jbussmann/glaL2-Leiterplatte/Spezifikation_Bussmann.pptx

## Spezifikation eigene Leiterplatte

Blockschaltbild

- B

Power

Stromversorgung
DC/DC Converter
In: 5-24V
Out: 3.3V, max. 3A

3-Phasen Brücke
verwendbar als:
- H-Brücke
- Push-Pull
- Open-Drain

Core

Analog

8x Single-Ended ADC
mit SGA x1 x10 x50 und
Sp.-Teiler x1/30 x1/3

2x Potentiometer

Digital/Interface

Embedded ST-LINK/V2-1

MicroSD Slot

8x RGB-LEDs via
latched Shift-Registers

QVGA LCD (320x240)
mit resistive Touch

SWD-Interface

Microcontroller
STMicroelectronics
ARM Cortex M4 + FPU
STM32F411VC
3x I2C/USART, 5x SPI
11x Timer, 12bit ADC

2 Achsen Joystick

5-Weg Taster

USB mit Serial + DFU

Rotary Encoder, gerastert

SPI, I2C, USART

## Spezifikation eigene Leiterplatte

Kostenrelevante Bauteile:
- ohne 0805/0603
- R E24, C E12
