jbussmann/glaL2-Leiterplatte/Datasheets_Comp/Thumbstick_Ada_P2765.jpg

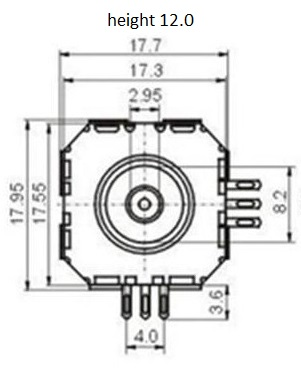
Datasheets_Comp/Thumbstick_Ada_P2765.jpg
