jbussmann/glaL2-Leiterplatte/Datasheets_MCU/Pinout.png

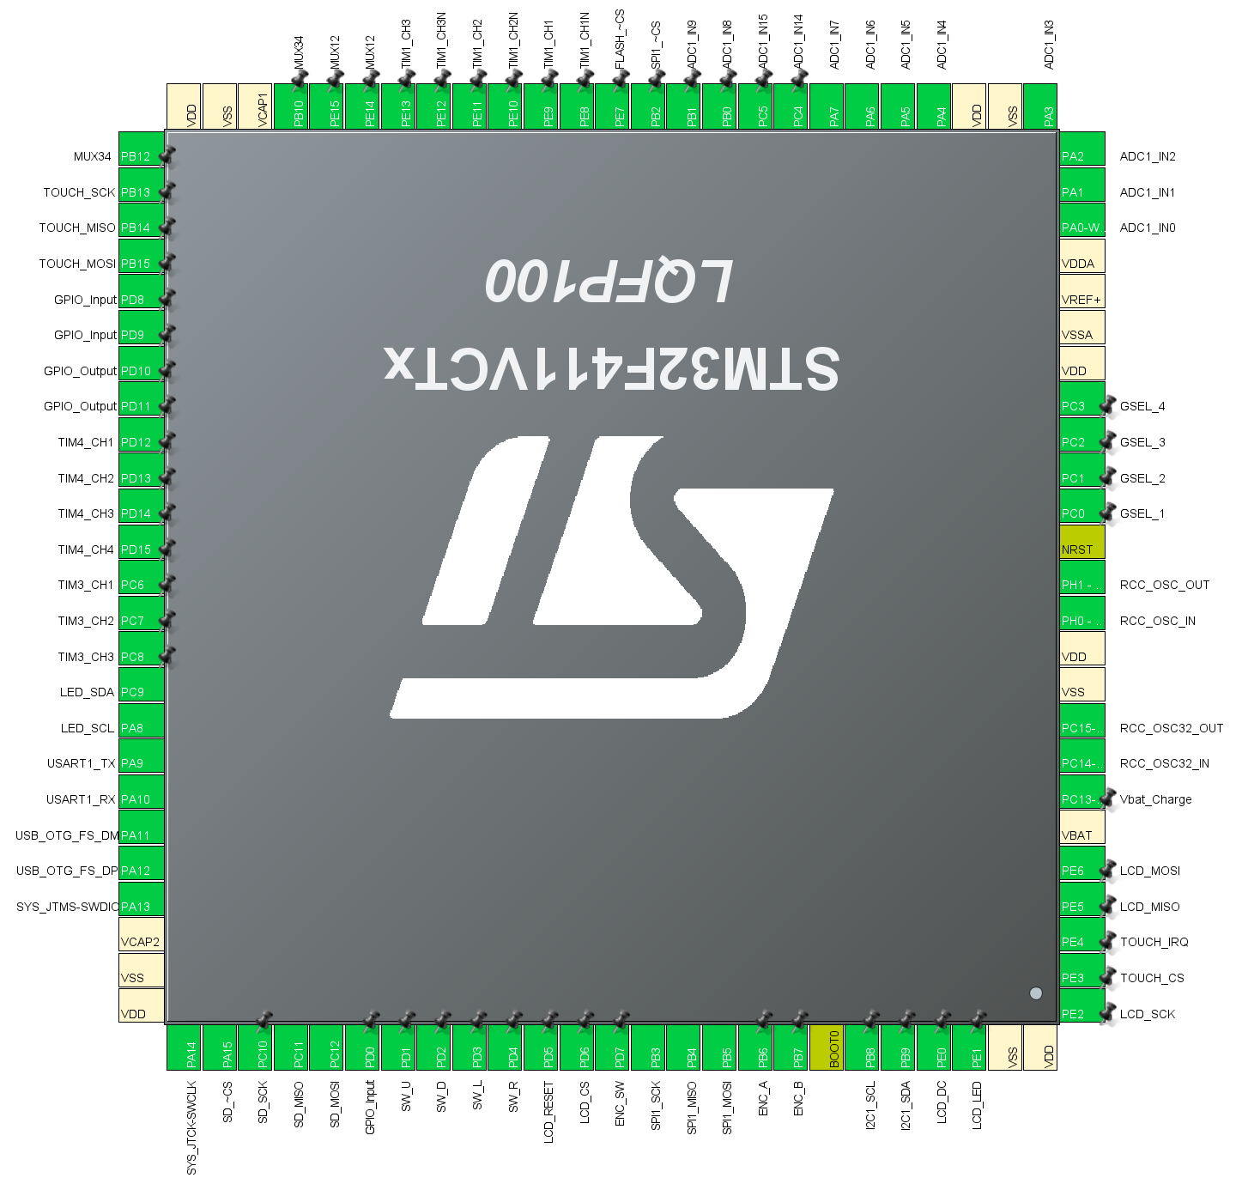
Datasheets_MCU/Pinout.png
