jbussmann/glaL2-Leiterplatte/Bauteilliste_Bussmann.xlsx

Qty | VALUE | MF | DESCRIPTION | Dist. | Order Nr. | Price | Total
 | Power
1 | AP63300WU-7 | Diodes inc | Schaltspannungsregler DCDC Conv HV Buck TSOT26 T&R 3K | Mouser | 621-AP63300WU-7 | 0.95
1 | ASPI-0630LR-5R6M-T15 | ABRACON | Festinduktivitäten FIXED IND 5.6UH 6A 35.5 MOHM SMD | Mouser | 810-VLS6045EX-4R7M | 0.79 | 0.79
1 | MIC5504-3.3YM5-TR | Micrel | LDO Spannungs-Regulator Single 300mA LDO | Mouser | 998-MIC5504-3.3YM5TR | 0.13 | 0.13
2 | MCP1804T-3302I/OT | Microchip | LDO Spannungs-Regulator 150mA LDO Vin 28V Vout =3.3V | Mouser | 579-MCP1804T-3302IOT | 0.66 | 1.32
4 | PMEG3020EGWX | Nexperia | Schottky Dioden & Gleichrichter SCHOTTKY DIODE | Mouser | 841-PMEG3020EGWX | 0.32 | 1.28
2 | 20020327-C021B01LF | Amphenol | Feste Anschlussblöcke 2P 3.50MM | Mouser | 649-220327-C021B01LF | 0.59
2 | 20020327-C051B01LF | Amphenol | Feste Anschlussblöcke 5P 3.50MM | Mouser | 649-220327-C051B01LF | 0.84 | 1.68
2 | 860010675018 | Wurth | Aluminium-Elektrolyt-Kondensatoren - Radial bedrahtet WCAP-ATG8 220uF 50V 20% Radial | Mouser | 710-860010675018 | 0.41 | 0.82
1 | GRM21BR61E226ME44K | Murata | MLCC - SMD/SMT 22UF 25V 20% 0805 | Mouser | 81-GRM21BR61E226ME4K | 0.44
3 | GRT21BR60J476ME13L | Murata | MLCC - SMD/SMT X5R 6.3Vdc 47uF VDC&Temp Derate Rcmd | Mouser | 81-GRT21BR60J476ME3L | 0.47
4 | 74279220601 | Wurth | Ferritperlen WE-MPSB 0805 100MHz 600Ohm 2100mA AECQ2 | Mouser | 710-74279220601 | 0.31
3 | STD64N4F6AG | STM | MOSFET LGS LV MOSFET | Mouser | 511-STD64N4F6AG | 0.62 | 1.86
3 | STD36P4LLF6 | STM | MOSFET LGS LV MOSFET | Mouser | 511-STD36P4LLF6 | 0.98 | 2.94
 | Core
1 | STM32F411VCT6 | STM | ARM Mikrocontroller - MCU 16/32-BITS MICROS | Mouser | 511-STM32F411VCT6 | 5.67
1 | STM32F103CBT6 | STM | ARM Mikrocontroller - MCU 32BIT Cortex M3 128K MED Performance LN | Mouser | 511-STM32F103CBT6 | 5.21
2 | ECS-80-8-30Q-VS-TR | ECS | Quarze 8MHz 8pF AEC ESR 100 -40C +125C | Mouser | 520-80-8-30Q-VST | 0.68 | 1.36
1 | CM8V-T1A-32.768kHz-4pF-20PPM-TA-QC T3 | Micro Crystal | Quarze 32.768 kHz 4.0 pF +/-20 PPM -40/+85C | Mouser | 428-202684-MC03 | 0.81 | 0.81
2 | USB3075-30-A | GCT | USB-Stecker Micro B Skt, Bottom-SMT, R/A, 30u No Peg, W/shell stake, T&R | Mouser | 640-USB3075-30-A | 0.63 | 1.26
4 | KMR421GULCLFS | C&K | Sensorschalter Tact | Mouser | 611-KMR421GULCLFS | 0.38 | 1.52
1 | BC847C | Nexperia | Bipolartransistoren - BJT NPN GP 100MA 45V | Mouser | 771-BC847C-T/R | 0.12
 | Analog
1 | MCP1501T-30E/CHY | Microchip | Spannungsreferenzen Precision Buffered Voltage Reference | Mouser | 579-MCP1501T-30E/CHY | 0.75 | 0.75
2 | RK10J11E0034 | Alps Alpine | Potentiometer Single Unit 10mm,1B insertion (2mm) | Mouser | 688-RK10J11E0034 | 1.43 | 2.86
1 | SKRHABE010 | Alps Alpine | Multi-direktionale Schalter 4-directn cntr push W/boss 200K Cycles | Mouser | 688-SKRHAB | 2.46 | 2.46
1 | 2765 | Adafruit | Adafruit Zubehör Mini 2-Axis Analog Thumbstick | Mouser | 485-2765 | 2.29 | 2.29
1 | PEC11S-929K-S0015 | Bourns | Encoder 9.5 MM SHAFT W/SWITCH 2 DET | Mouser | 652-PEC11S929K-S0015 | 2.1 | 2.1
4 | MCP6G02-E/MS | Microchip | Sonderverstärker Single Selectable Gain Amplifiers | Mouser | 579-MCP6G02-E/MS | 0.6 | 2.4
 | Digital/Interface
8 | CLV1L-FKB-CJ1N1E1BB7B3B3 | Cree | Standard-LEDs - SMD RGB SMD | Mouser | 941-CLV1LFKBCJ1N1E1B | 0.34 | 2.72
5 | 150060VS55040 | Wurth | Standard-LEDs - SMD WL-SMCD SMD MonoChip 0603 BrtGrn 575nm | Mouser | 710-150060VS55040 | 0.17
4 | 150060SS55040 | Wurth | Standard-LEDs - SMD WL-SMCD SMD MonoChip 0603 Super Red 645nm | Mouser | 710-150060SS55040 | 0.17
2 | LP5012PWR | TI | 12-channel I2C constant-current RGB LED driver 24 | Mouser | 595-LP5012PWR | 1.19 | 2.38
1 | BZT52C11TQ-7-F | Diodes inc | Zener-Dioden Zener Diode SOD523 | Mouser | 621-BZT52C11TQ-7-F | 0.26 | 0.26
3 | SMH-104-02-T-S | Samtec | Sockel & Kabelgehäuse .100 Horizontal Surface Mount 4-Pin | Mouser | 200-SMH10402TS | 0.9 | 2.7
3 | SMH-106-02-T-S | Samtec | Sockel & Kabelgehäuse .100 Horizontal Surface Mount 6-Pin | Mouser | 200-SMH10602TS | 0.97 | 2.91
1 | MEM2061-01-188-00-A | GCT | Speicherkartenverbinder Micro SD Push Push, Closed, SMT, 1.88mm profile | Mouser | 640-MEM20610118800A | 1.06
1 | AT25SF641B-SHB-B | Adesto | NOR-Flash 64 Mbit, 3.0V (2.7V to 3.6V), -40C to 85C, SOIC-W 208mil (Tube) | Mouser | 988-AT25SF641B-SHB-B | 0.87 | 0.87
1 |  |  | Display LCD Touch 2.4" QVGA | ebay | 284089088933 | 8
 |  |  |  |  |  | TOTAL | 40.47
