jbussmann/glaL2-Leiterplatte/Vorlage_Bestellliste.xlsx

 | Qty | Reference | VALUE | MF | DESCRIPTION | Dist. | Order Nr. | Price | Total
1 | 1 | D104 | NRVBS3100T3G | On-Semi | Schottky-Gleichrichterdiode, AEC-Q101, 100 V, 3 A, Einfach, SMC, 2 Pin(s), 900 mV | Farnell | 2533243 | 0.46 | 0.46
2 | 2 | D102, D103 | B360A-13-F | Diodes inc | Schottky Dioden & Gleichrichter 60V 3A Schottky Dioden & Gleichrichter 60V 3A | Mouser | 621-B360A-F | 0.14 | 0.28
3 | 2 | RV401, RV402 | RK09K1130AH1 | Alps | RK09K1130AH1 - Drehpotentiometer, 10 kohm, 1 Umdrehung(en), Linear, 50 mW, ± 20%, Baureihe RK09 | Farnell | 1191725 | 0.768 | 1.536
4 | 1 | J102 | TB007-508-02BE | CUI | 2-Pol Anschlussblock schraubbar, 5.08mm | Mouser | 490-TB007-508-02BE | 0.203 | 0.203
5 | 3 | J201, J203, J503 | TB007-508-04BE | CUI | 4-Pol Anschlussblock schraubbar, 5.08mm | Mouser | 490-TB007-508-04BE | 0.405 | 1.215
6 | 1 | J202 | TB007-508-05BE | CUI | 5-Pol Anschlussblock schraubbar, 5.08mm | Mouser | 490-TB007-508-05BE | 0.602 | 0.602
7 | 2 | JP101, JP302 | 77311-118-02LF | FCI | CONN HEADER VERT 2POS 2.54MM | Mouser | 649-77311-118-02LF | 0.123 | 0.246
8 | 1 | J401 | M20-7820446 | Harwin | Sockel & Kabelgehäuse 4 PIN SIL VERTICAL SOCKET TIN | Mouser | 855-M20-7820446 | 0.62 | 0.62
9 | 1 | external | SBC-OLED01 | JOY-IT | DEBO OLED2 0.96 Entwicklerboards - Display, 0,96", OLED-Display, SSD1306 | Reichelt | DEBO OLED2 0.96 | 6.51 | 6.51
10 | 1 | D401 | ASMB-MTB0-0A3A2 | Broadcom | LED, RGB, Rot, Grün, Blau, Oberflächenmontage, 2.4mm, 115 °, Rund, R 20mA, G 20mA, B 20mA | Farnell | ASMB-MTB0-0A3A2 | 0.398 | 0.398
11 | 1 | U101 | TPS54331D | TI | Schaltspannungsregler 3A 28V In Step Down SWIFT DC/DC Cnvrtr | Mouser | 595-TPS54331D | 1.55 | 1.55
12 | 1 | L101 | 7447779006 | Wurth | Festinduktivitäten WE-PD 7345 6.8uH 2.91A .033Ohm | Mouser | 710-7447779006 | 1.91 | 1.91
13 | 1 | U304 | STM32F070RBT6 | STM | ARM Mikrocontroller - MCU Mainstream ARM Cortex-M0 Value line MCU with 128 Kbytes Flash, 48 MHz CPU, USB | Mouser | 511-STM32F070RBT6 | 2.35 | 2.35
14 | 6 | Q201, Q202, Q203, Q204, Q205, Q206 | NVD3055L170T4GVF | On-Semi | MOSFET NFET DPAK 60V 9A 1 70MOHM | Mouser | 863-NVD3055L170T4GVF | 0.413 | 2.478
15 | 3 | F201, F202, F203 | 0ZCH0020FF2E | Bel-Fuse | Rückstellbare Sicherungen - PPTC Fuse 0.2A Haltestrom 0.4A Auslösestrom 30V | Mouser | 530-0ZCH0020FF2E | 0.067 | 0.201
16 | 3 | D203, D204, 402 | BAV99HMFHT116 | ROHM | Dioden (Allzweck, Leistung, Schaltung) 100V Vrm; 500mA Ifm Swtch Diode SOT-23 | Mouser | 755-BAV99HMFHT116 | 0.062 | 0.186
17 | 1 | J101 | 629105150521 | Wurth | USB-Steckverbinder, mit Einraststiften, Micro-USB Typ B | Farnell | 2470822 | 1.58 | 1.58
18 | 6 | SW301, SW401, SW402, SW403, SW404, SW405 | FSM6JH | TE | Sensorschalter SPST OFF-(ON) Round pushbutton | Mouser | 506-FSM6JH | 0.11 | 0.66
19 | 1 | U501 | ADUM1201AR | Analog Devices | Digitale Isolatoren DUAL-CHANNEL DIGITAL ISOLATORS | Mouser | 584-ADUM1201AR | 2.98 | 2.98
20 | 1 | U502 | MAX13487EESA+ | MAXIM | RS-422/RS- 485-Schnittstelle IC Half-Duplex RS-485/RS-422-Compatible Transceiver with AutoDirection Control | Mouser | 700-MAX13487EESA | 2.16 | 2.16
21 | 1 | SW406 | PEC12R-4015F-S00024 | Bourns | PEC12R-4015F-S0024 Inkrementalgeber | Mouser | 652-PEC12R4015FS0024 | 1.07 | 1.07
22 | 1 | D403 | LTP-305G | Liteon | LED 5 x 7 Dot Matrix | Mouser | 859-LTP-305G | 2.2 | 2.2
23 | 1 | Y301 | ABS25-32.768KHZ-6-T | Abracon | Quarze 32.768KHz 6pF 20ppm -40C +85C | Mouser | 815-ABS25-32.768K6-T | 0.466 | 0.466
24 | 1 | Y302 | HC49SDLF-8.00MHz | FOX | Quarze 8MHz 12pF -20C +70C 30ppm | Mouser | 559-FOXSDLF/080-12 | 0.302 | 0.302
25 | 6 | D201, D202, D205, D206, D207, D208 | FM240A | Rectron | 40V 2A SMB Diode | Mouser | 583-FM240A | 0.093 | 0.558
26 | 2 | C102, C208 | ESW227M050AH2AA | Kemet | Aluminium-Elektrolyt-Kondensatoren - Radial bedrahtet 50V 220uF 105C 5k Hour Radial | Mouser | 80-ESW227M050AH2AA | 0.314 | 0.628
27 | 1 | C111 | EEU-FR1A471 | Panasonic | Aluminium-Elektrolyt-Kondensatoren - Radial bedrahtet 10VDC 470uF 20% L/S=3.5mm | Mouser | 667-EEU-FR1A471 | 0.244 | 0.244
28 | 1 | D101 | SMAJ28AQ-13-F | Diodes inc | ESD-Entstörer/TVS-Dioden 400W Transient Voltage Suppressor | Mouser | 621-SMAJ28AQ-13-F | 0.288 | 0.288
29 | 1 | external |  |  | SWD Program Adapter |  |  | 12 | 12
30 | 2 | C106, C107 | ESW226M010AC3AA | Kemet | Aluminium-Elektrolyt-Kondensatoren - Radial bedrahtet 10V 22uF 105C 3k Hour Radial | Mouser | 80-ESW226M010AC3AA | 0.078 | 0.156
31 | 4 | FB101, FB102, FB103, FB301 | 74279220601 | Wurth | Ferritperle, 0805 [Metrisch 2012], 600 ohm, 2.1 A, Baureihe WE-MPSB, 0.08 ohm, ± 25% | Farnell | 2467189 | 0.27 | 1.08
32 | 1 | J301 | M20-7820646 | Harwin | Sockel & Kabelgehäuse 6 PIN SIL VERTICAL SOCKET TIN | Mouser | 855-M20-7820646 | 0.728 | 0.728
33 | 1 | Q401 | BC847C | Nexperia | Bipolartransistoren - BJT NPN GP 100MA 45V | Mouser | 771-BC847C-T/R | 0.1 | 0.1
34 | 1 | U305 | SN65220DBVT | TI | ESD-Entstörer/TVS-Dioden Single USB Port | Mouser | 595-SN65220DBVT | 0.8 | 0.8
35 | 1 | U303 | ULN2003 | TI | Darlington Transistors | Mouser | 595-ULN2003V12DR | 0.473 | 0.473
36 | 2 | U301, U302 | 74HC164 | TI | Counter Shift Register | Mouser | 595-CD74HC164ME4 | 0.637 | 1.274
37 | 1 | LS401 | Speaker | PUI Audio | Lautspecher SMD | Mouser | 665-SMT-0927-S-12-R | 1.61 | 1.61
38 | 1 | J402 | AudioJack3 | CUI Devices | 3.5 Audio Jack | Mouser | 490-SJ1-3533NG | 0.85 | 0.85
 |  |  |  |  |  |  |  | TOTAL | 52.952
