jbussmann/glaL2-Leiterplatte/Vorlage_Schema.pdf

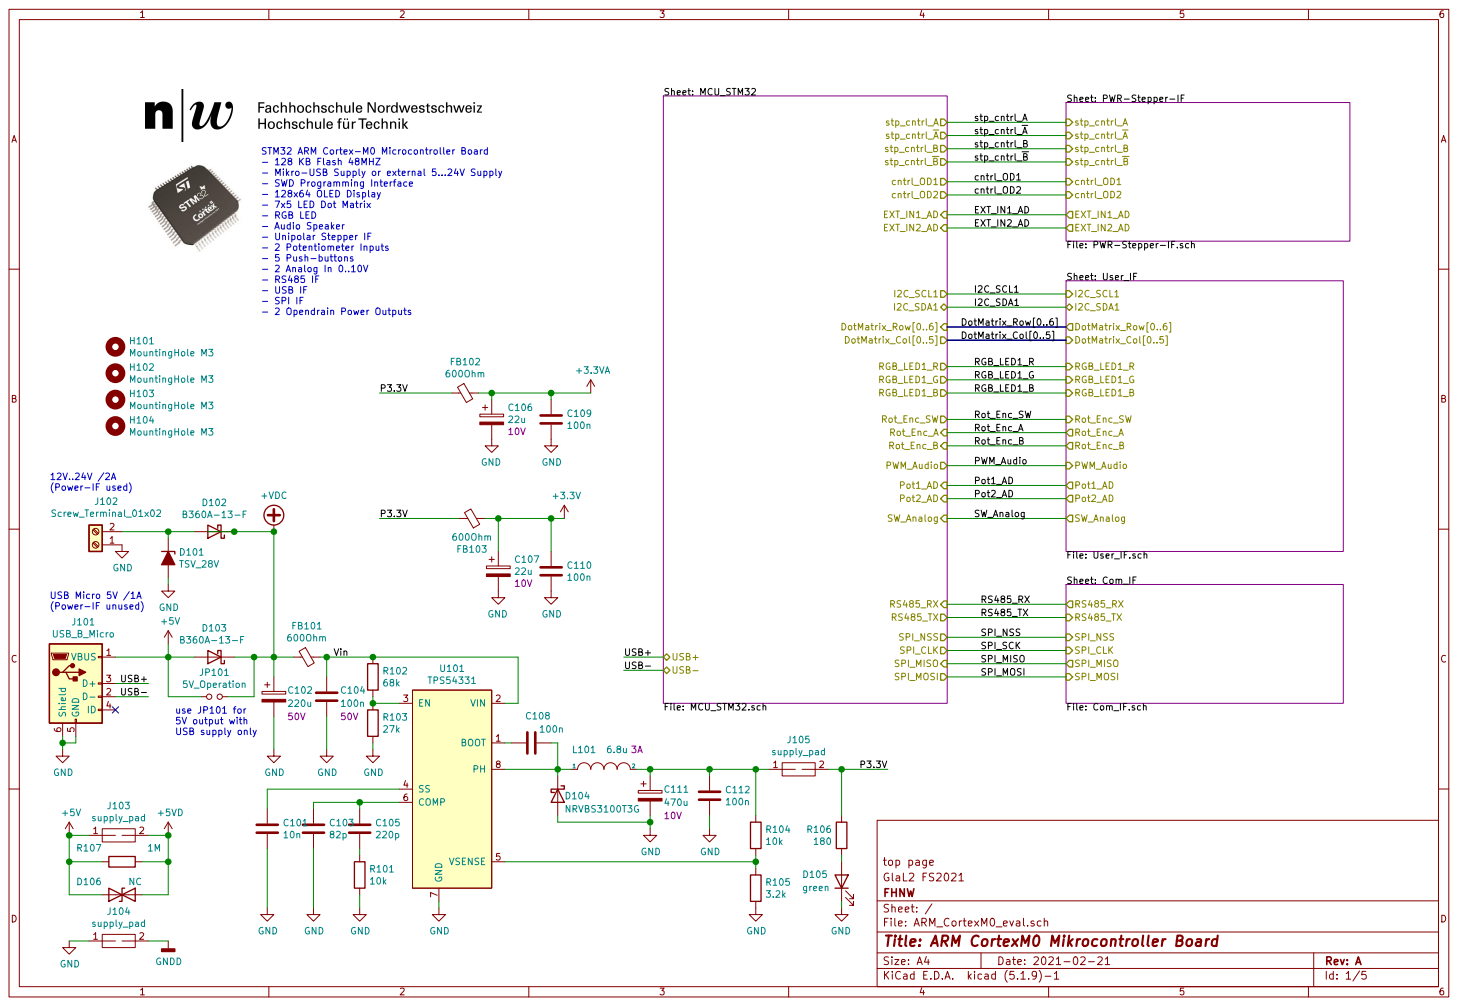
[picture p6: page 1]

STM32 ARM Cortex-M0 Microcontroller Board
- 128 KB Flash 48MHZ - Mikro-USB Supply or external 5...24V Supply

I2C_SCL1 USB- USB+ USB Micro 5V /1A

180 H104 MountingHole M3 H103 MountingHole M3 H102 MountingHole M3 H101 MountingHole M3

GlaL2 FS2021
File: ARM_CortexM0_eval.sch Sheet: / FHNW

Id: 1/5 Title: ARM CortexM0 Mikrocontroller Board

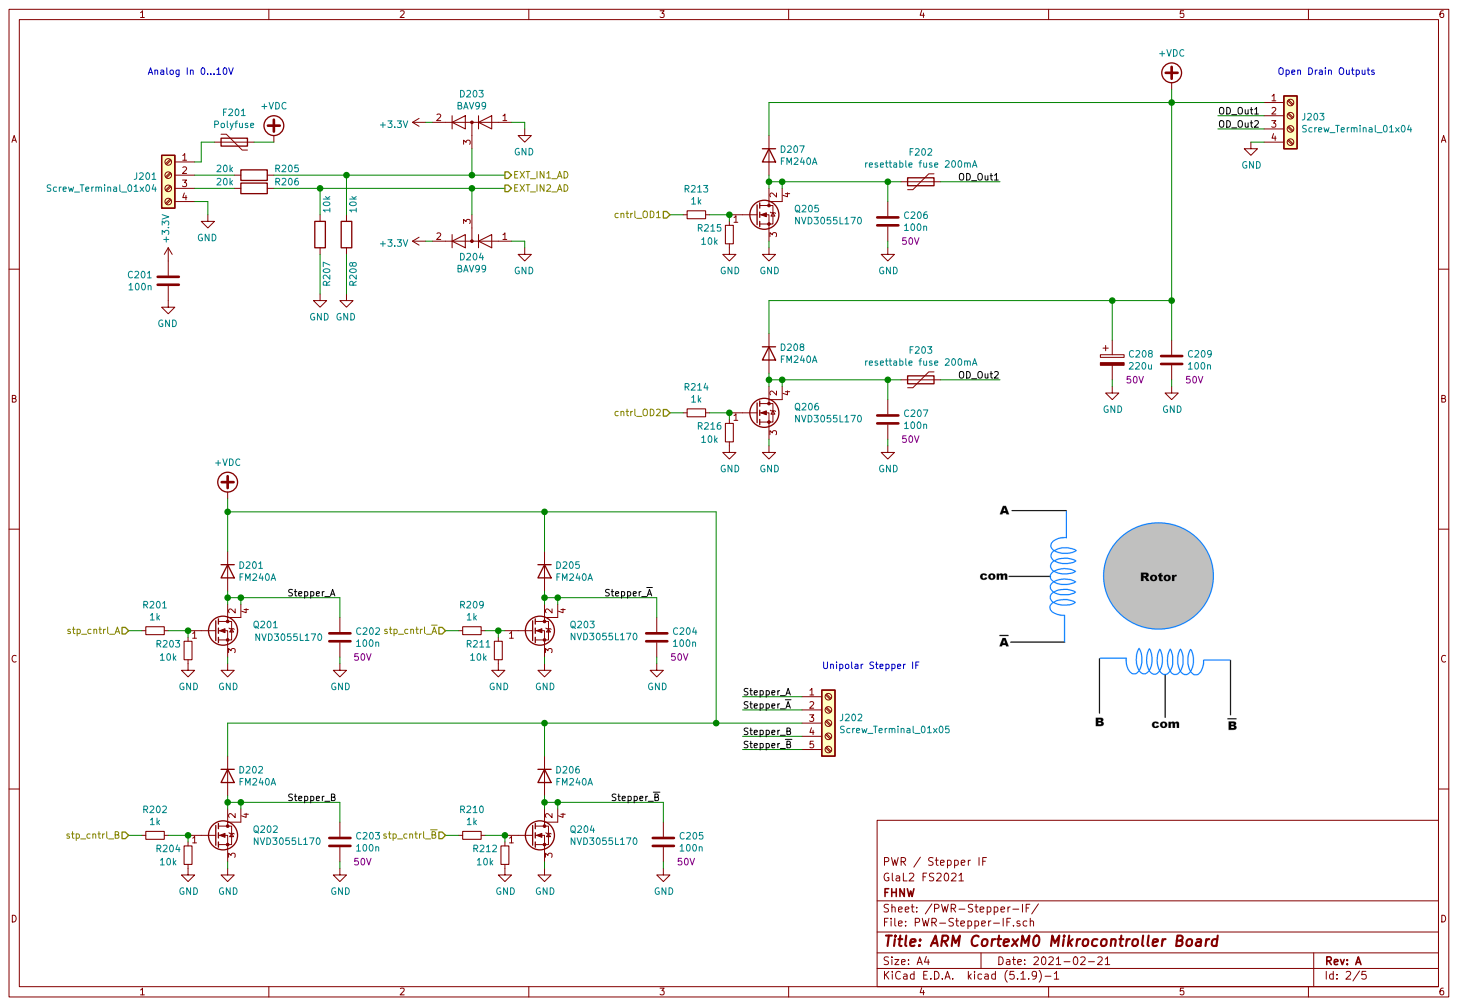
[picture p7: page 2]

Sheet: /PWR-Stepper-IF/ FHNW

File: PWR-Stepper-IF.sch
Id: 2/5 Title: ARM CortexM0 Mikrocontroller Board

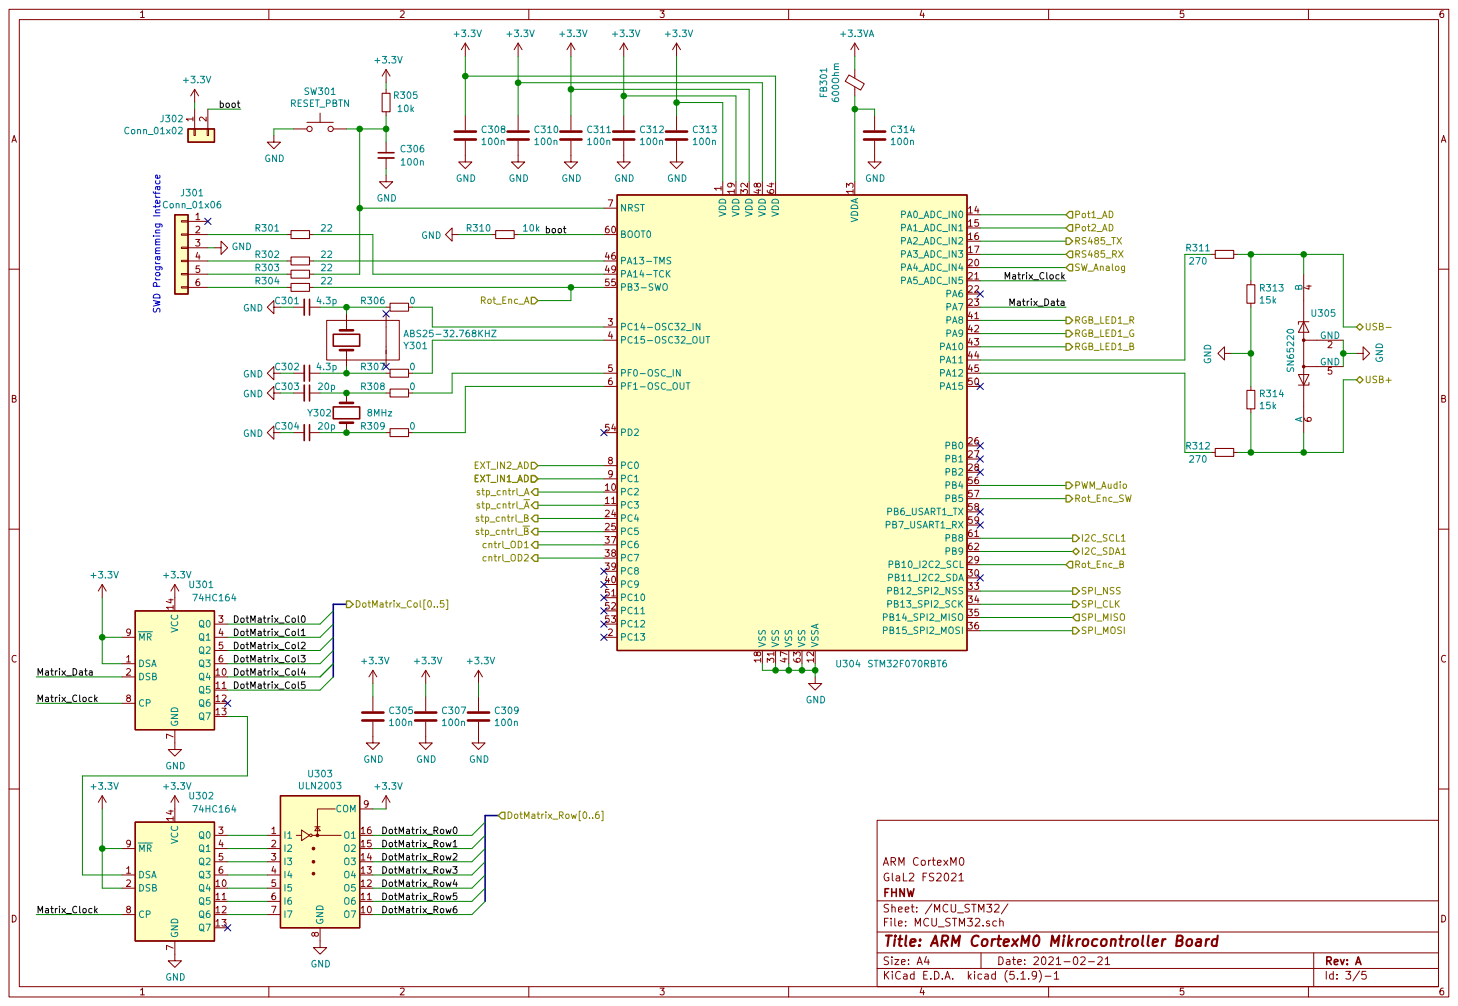
[picture p8: page 3]

1 PC2 10 PC3 11 VSSA 12 VDDA 13 PA0_ADC_IN0 14 PA1_ADC_IN1 15 PA2_ADC_IN2 16 PA3_ADC_IN3 17 VSS 18 VDD 19 PC13 2 PA4_ADC_IN4 20 PA5_ADC_IN5 21 PA6 22 PA7 23 PC4 24 PC5 25 PB0 26 PB1 27 PB2 28 PB10_I2C2_SCL 29 PC14-OSC32_IN 3 PB11_I2C2_SDA 30 VSS 31 VDD 32 PB12_SPI2_NSS 33 PB13_SPI2_SCK 34 PB14_SPI2_MISO 35 PB15_SPI2_MOSI 36 PC6 37 PC7 38 PC8 39 PC15-OSC32_OUT 4 PC9 40 PA8 41 PA9 42 PA10 43 PA11 44 PA12 45 PA13-TMS 46 VSS 47 VDD 48 PA14-TCK 49 PF0-OSC_IN 5 PA15 50 PC10 51 PC11 52 PC12 53 PD2 54 PB3-SWO 55 PB4 56 PB5 57 PB6_USART1_TX 58 PB7_USART1_RX 59 PF1-OSC_OUT 6 BOOT0 60 PB8 61 PB9 62 VSS 63 VDD 64 NRST 7 PC0 8 PC1 9 U304 STM32F070RBT6

File: MCU_STM32.sch
Id: 3/5 Title: ARM CortexM0 Mikrocontroller Board

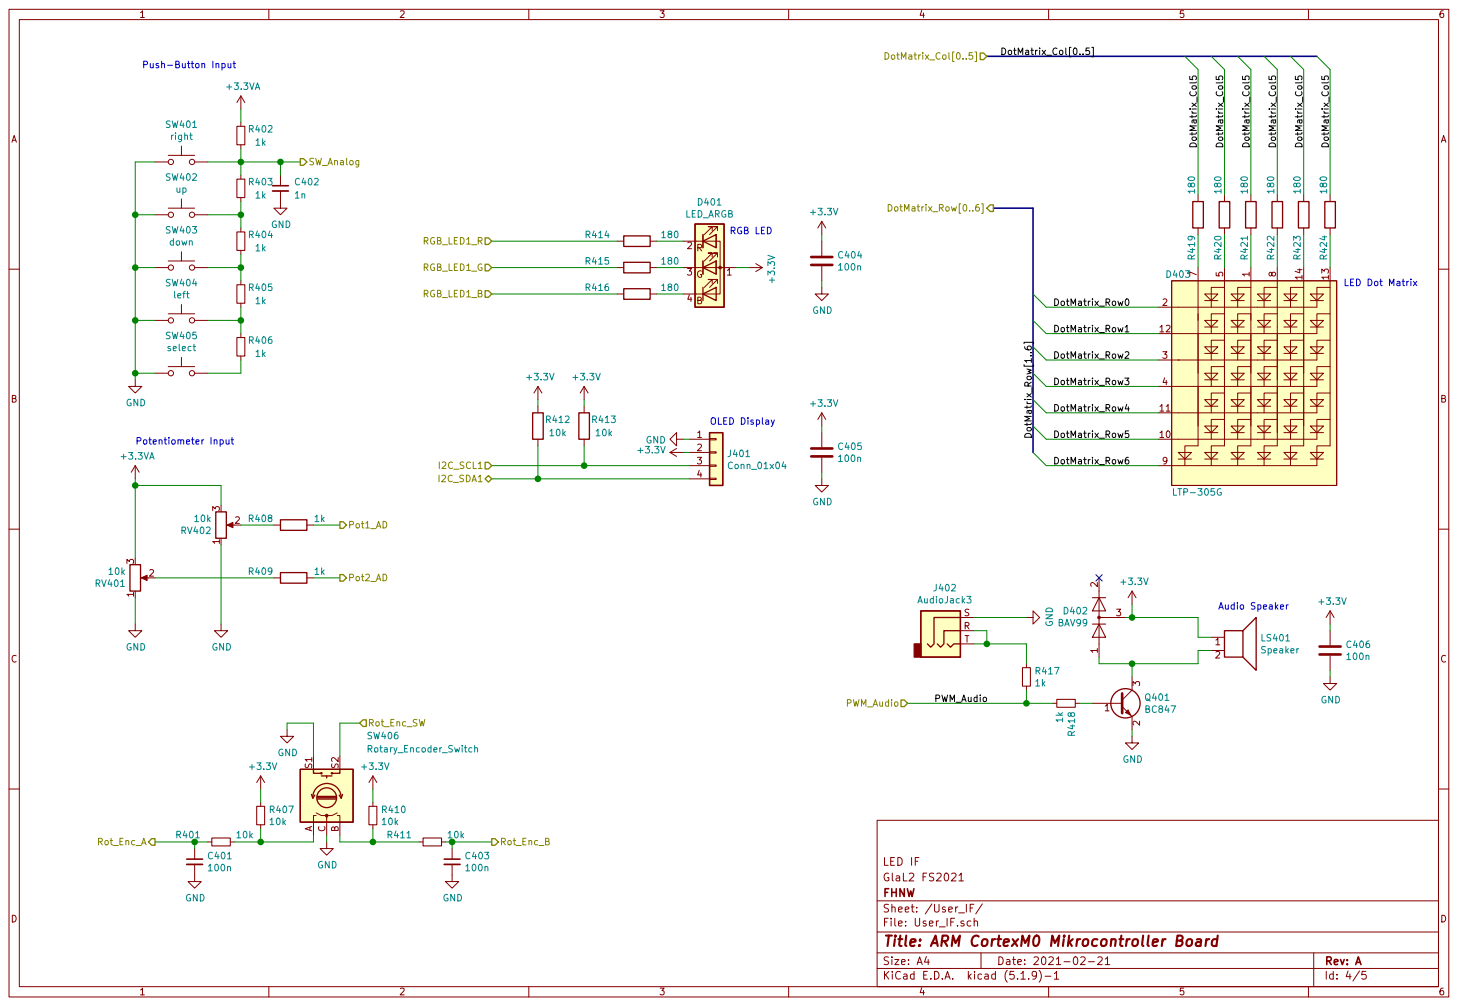
[picture p9: page 4]

File: User_IF.sch
Id: 4/5 Title: ARM CortexM0 Mikrocontroller Board

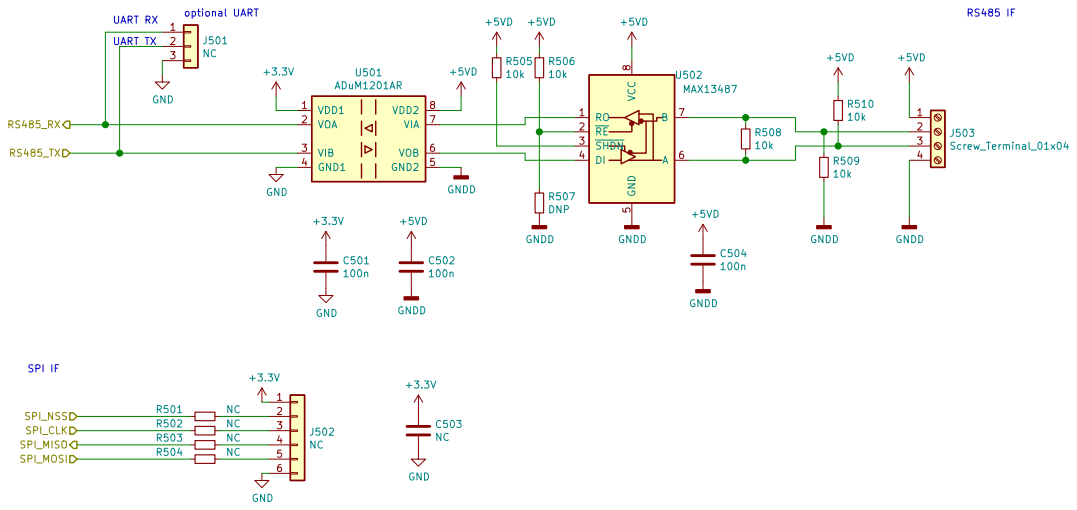
[picture p10: page 5]

optional UART UART RX

File: Com_IF.sch
Id: 5/5 Title: ARM CortexM0 Mikrocontroller Board
