jbussmann/glaL2-Leiterplatte/KiCad/PDF/STM32-Evalboard-B_Fab.pdf

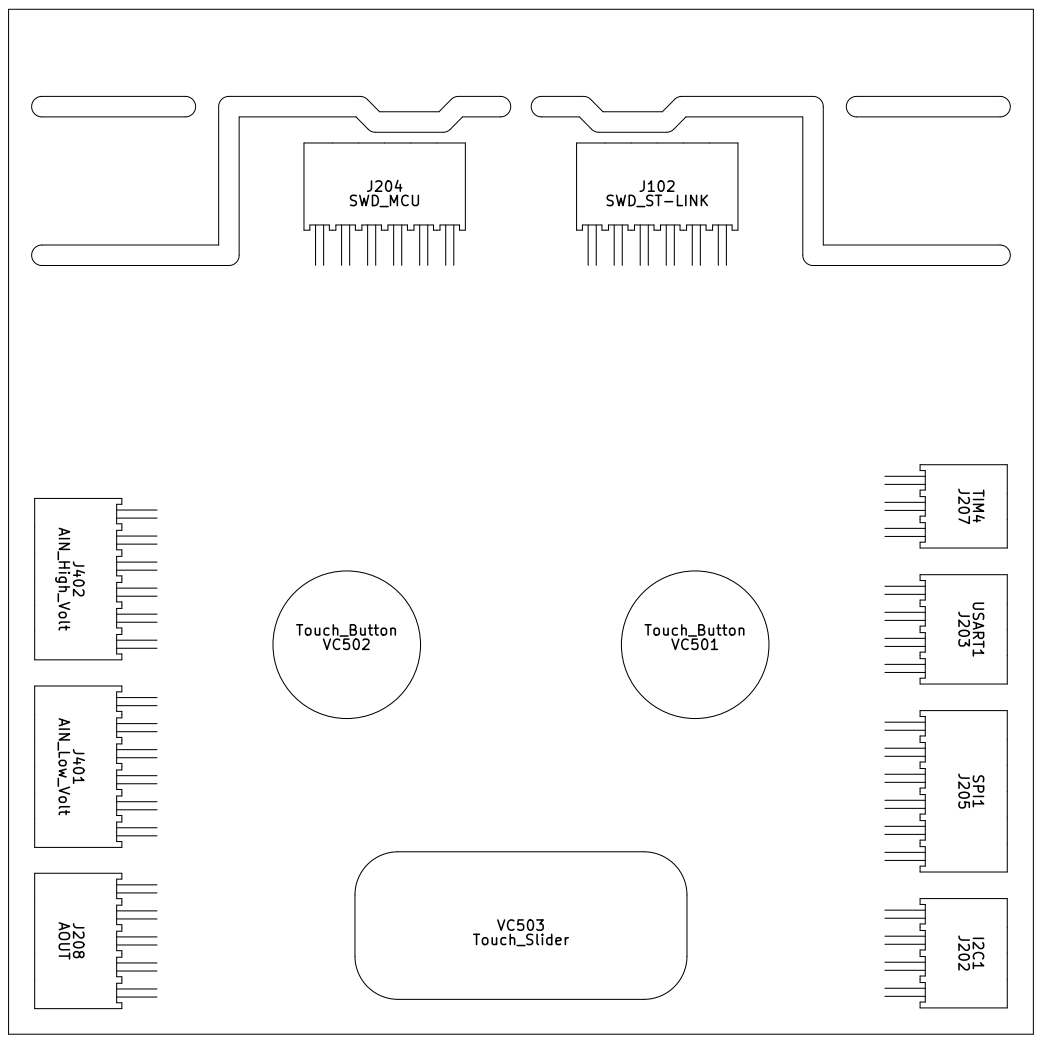
[picture p11: page 1]

File: STM32-Evalboard.kicad_pcb Sheet: by Jonas Bussmann
