jbussmann/glaL2-Leiterplatte/KiCad/PDF/STM32-Evalboard-F_Fab.pdf

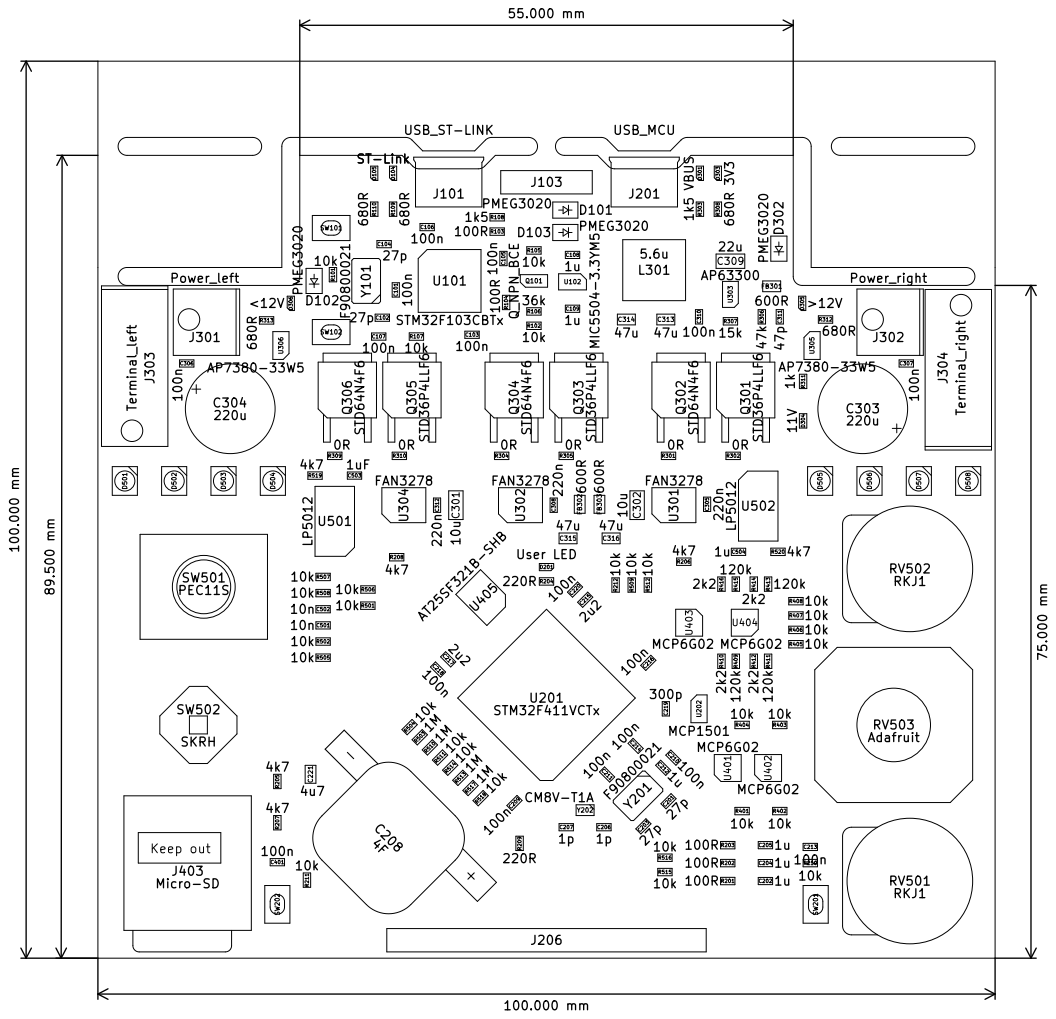
[picture p12: page 1]

File: STM32-Evalboard.kicad_pcb Sheet: by Jonas Bussmann 89.500 mm100.000 mm
