jbussmann/glaL2-Leiterplatte/KiCad/PDF/STM32-Evalboard.pdf

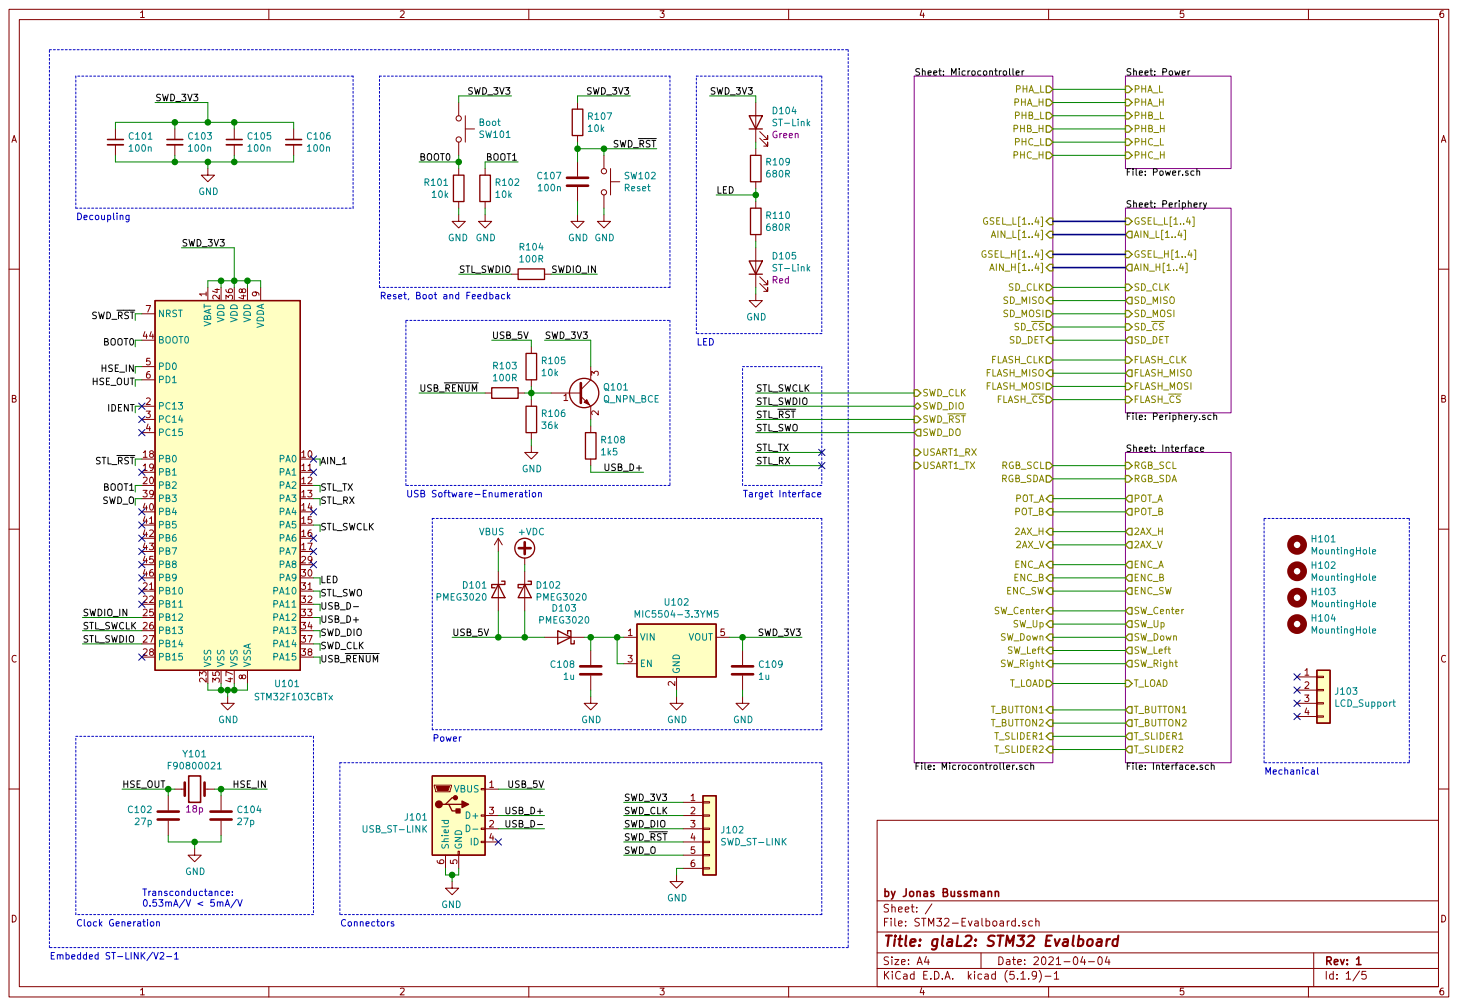
[picture p13: page 1]

Sheet: Power File: Power.sch PHA_L PHA_H

D105 ST-Link Red D104 ST-Link Green R104

1 VDD 24 VDD 36 VDD 48 VDDA

9 VSS 23 VSS 35 VSS 47 VSSA

+VDC
LCD_Support H104 MountingHole H103 MountingHole H102 MountingHole H101 MountingHole D103 PMEG3020

File: STM32-Evalboard.sch Sheet: / by Jonas Bussmann

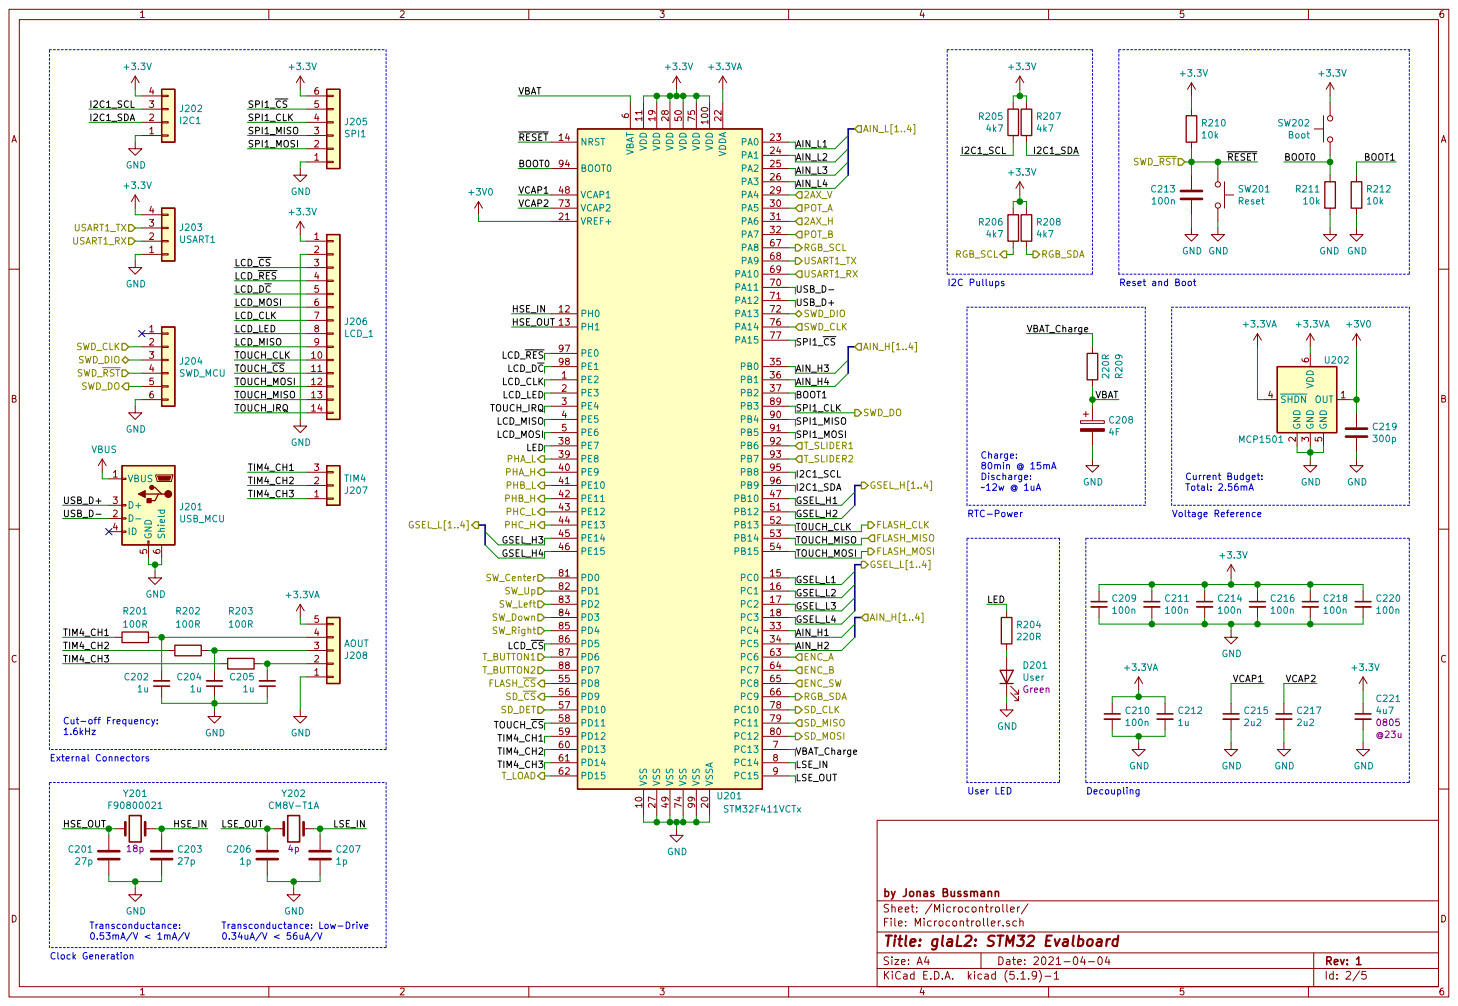
[picture p14: page 2]

6 VCAP1 48 VCAP2 73 VDD 100 VDD 11 VDD 19 VDD 28 VDD 50 VDD 75 VDDA 22 VREF+ 21 VSS 10 VSS 27 VSS 49 VSS 74 VSS 99 VSSA 20U201 STM32F411VCTx 1

Current Budget: Total: 2.56mA User LED

Voltage Reference Transconductance: Low-Drive

File: Microcontroller.sch Sheet: /Microcontroller/ by Jonas Bussmann R203

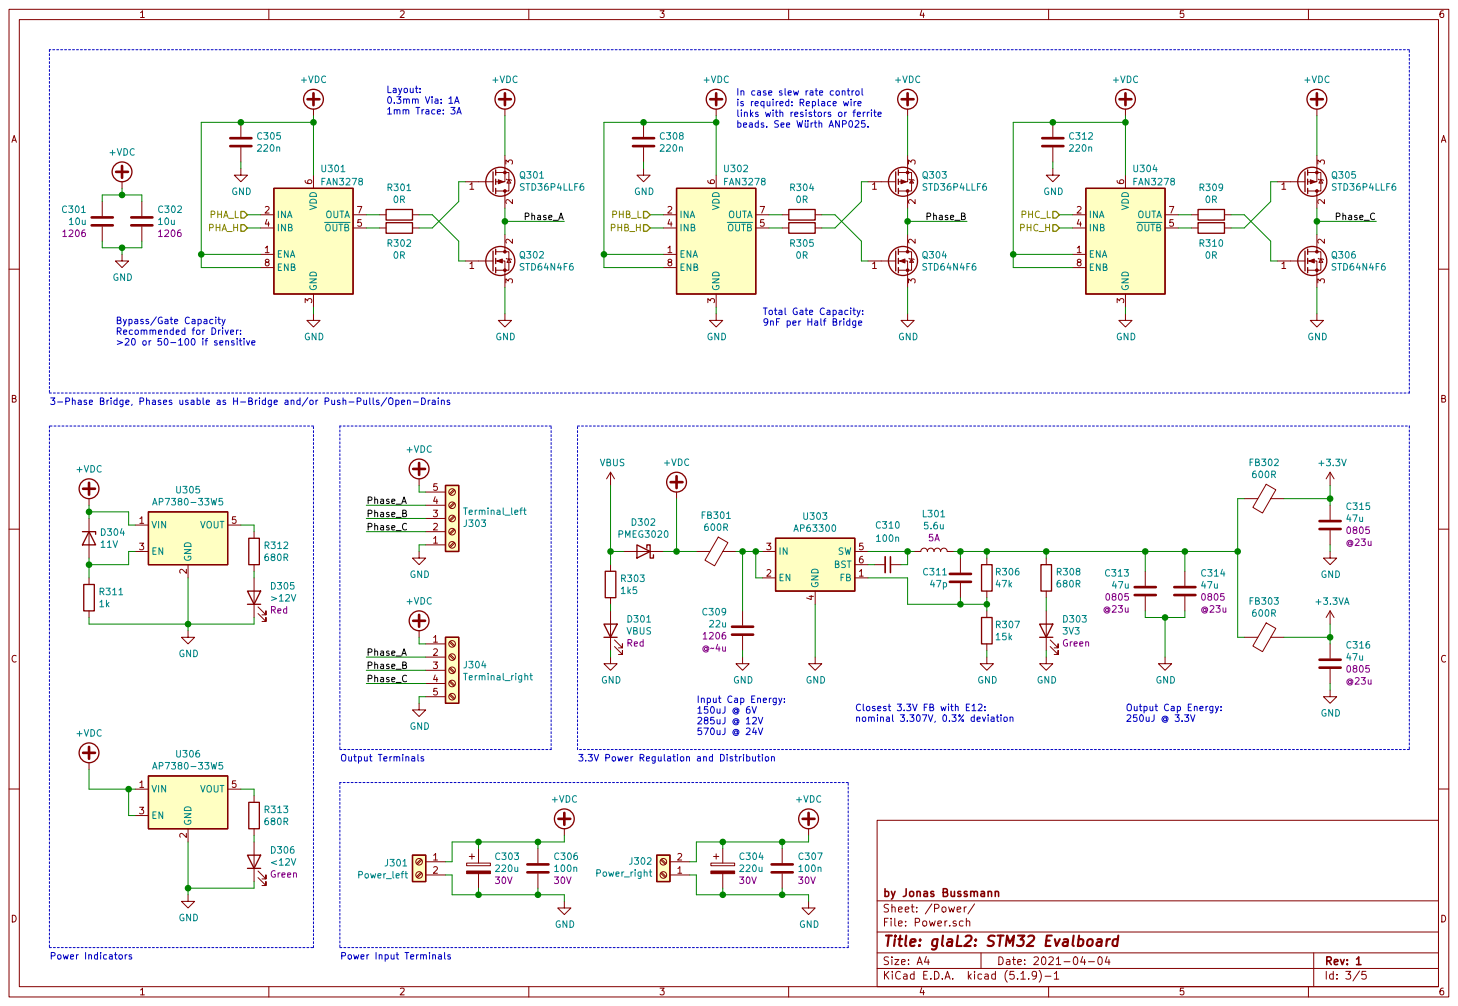
[picture p15: page 3]

In case slew rate control
is required: Replace wire
links with resistors or ferrite

beads. See Würth ANP025. Closest 3.3V FB with E12: nominal 3.307V, 0.3% deviation Power Indicators

Bypass/Gate Capacity Recommended for Driver: >20 or 50-100 if sensitive

3-Phase Bridge, Phases usable as H-Bridge and/or Push-Pulls/Open-Drains

3.3V Power Regulation and Distribution

File: Power.sch Sheet: /Power/ by Jonas Bussmann

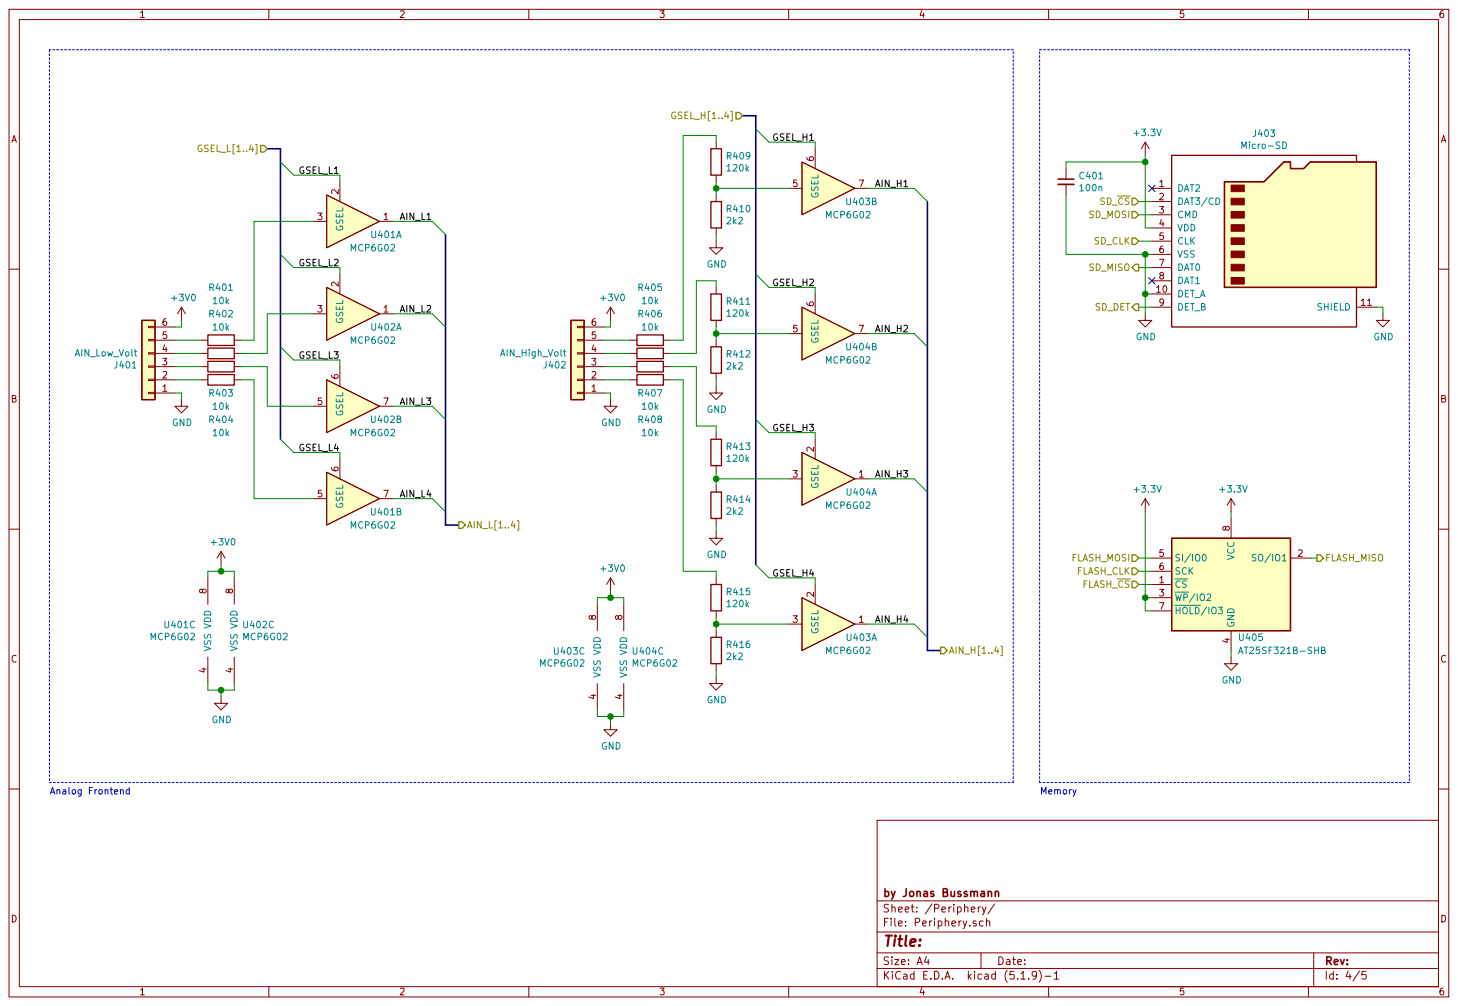
[picture p16: page 4]

4 SI/IO0 5 SCK 6 HOLD/IO3 7 VCC

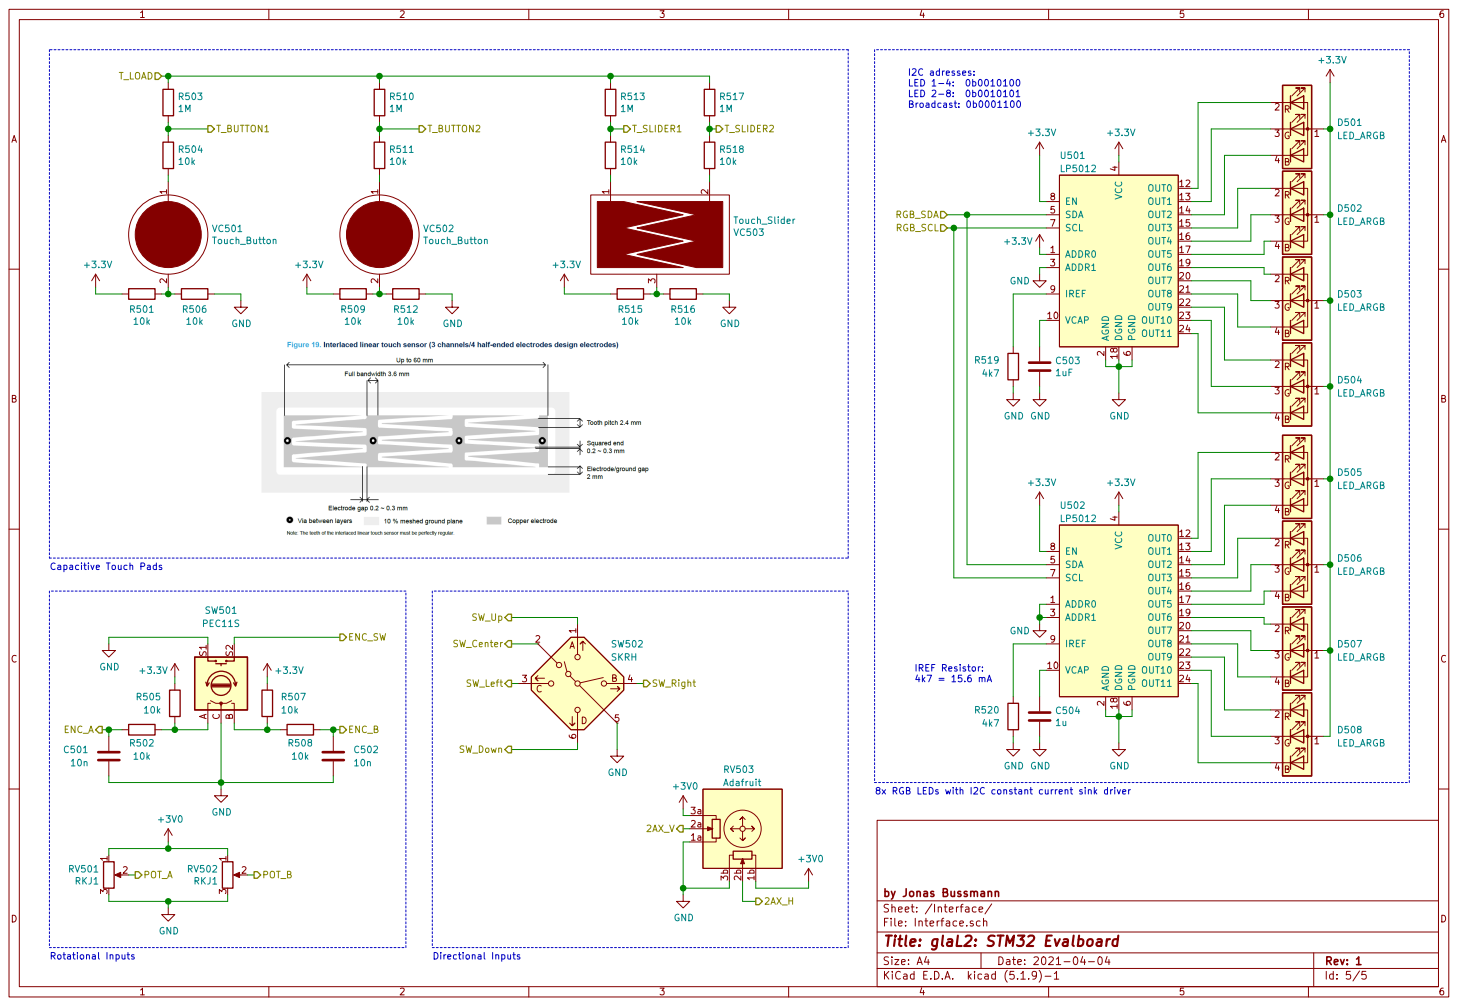
[picture p17: page 5]

IREF Resistor: 4k7 = 15.6 mA Directional Inputs

8x RGB LEDs with I2C constant current sink driver Rotational Inputs

File: Interface.sch Sheet: /Interface/ by Jonas Bussmann
