jbussmann/glaL2-Leiterplatte/KiCad/PDF/F_Fab_print.pdf

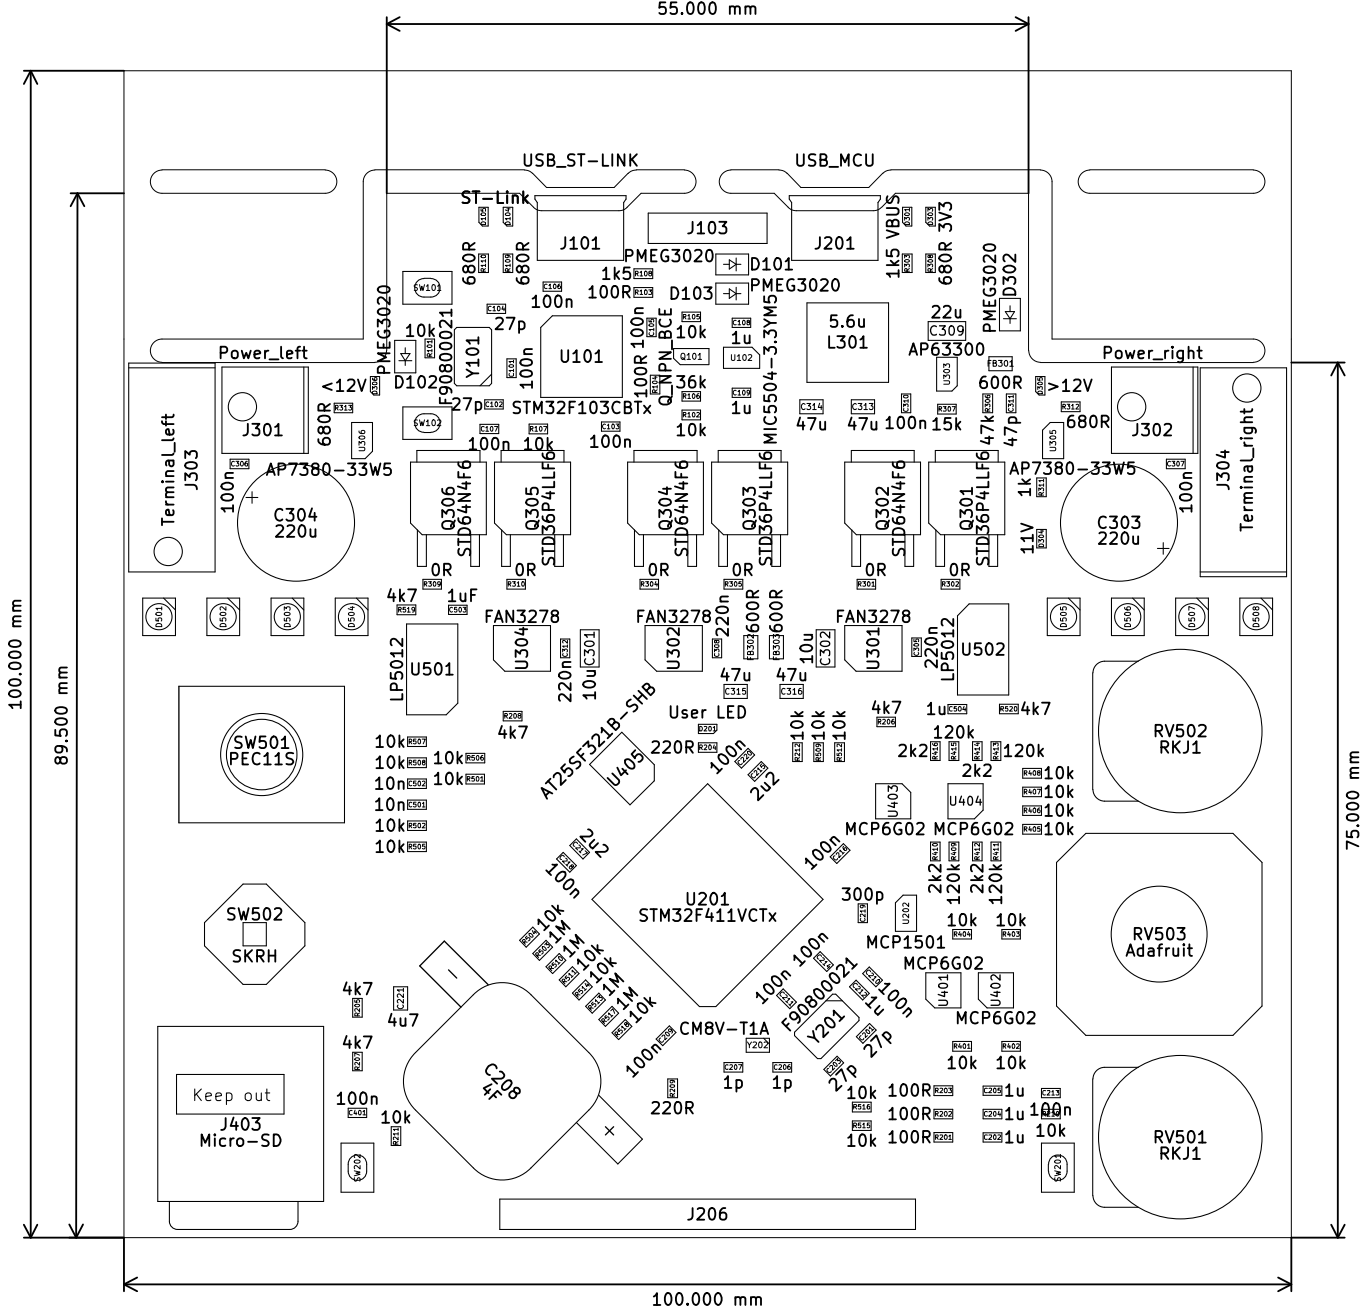
[picture p20: page 1]
