jbussmann/glaL2-Leiterplatte/KiCad/STM32-Evalboard.kicad_pcb

## KiCad design KiCad/STM32-Evalboard.kicad_pcb (2021-08-02)

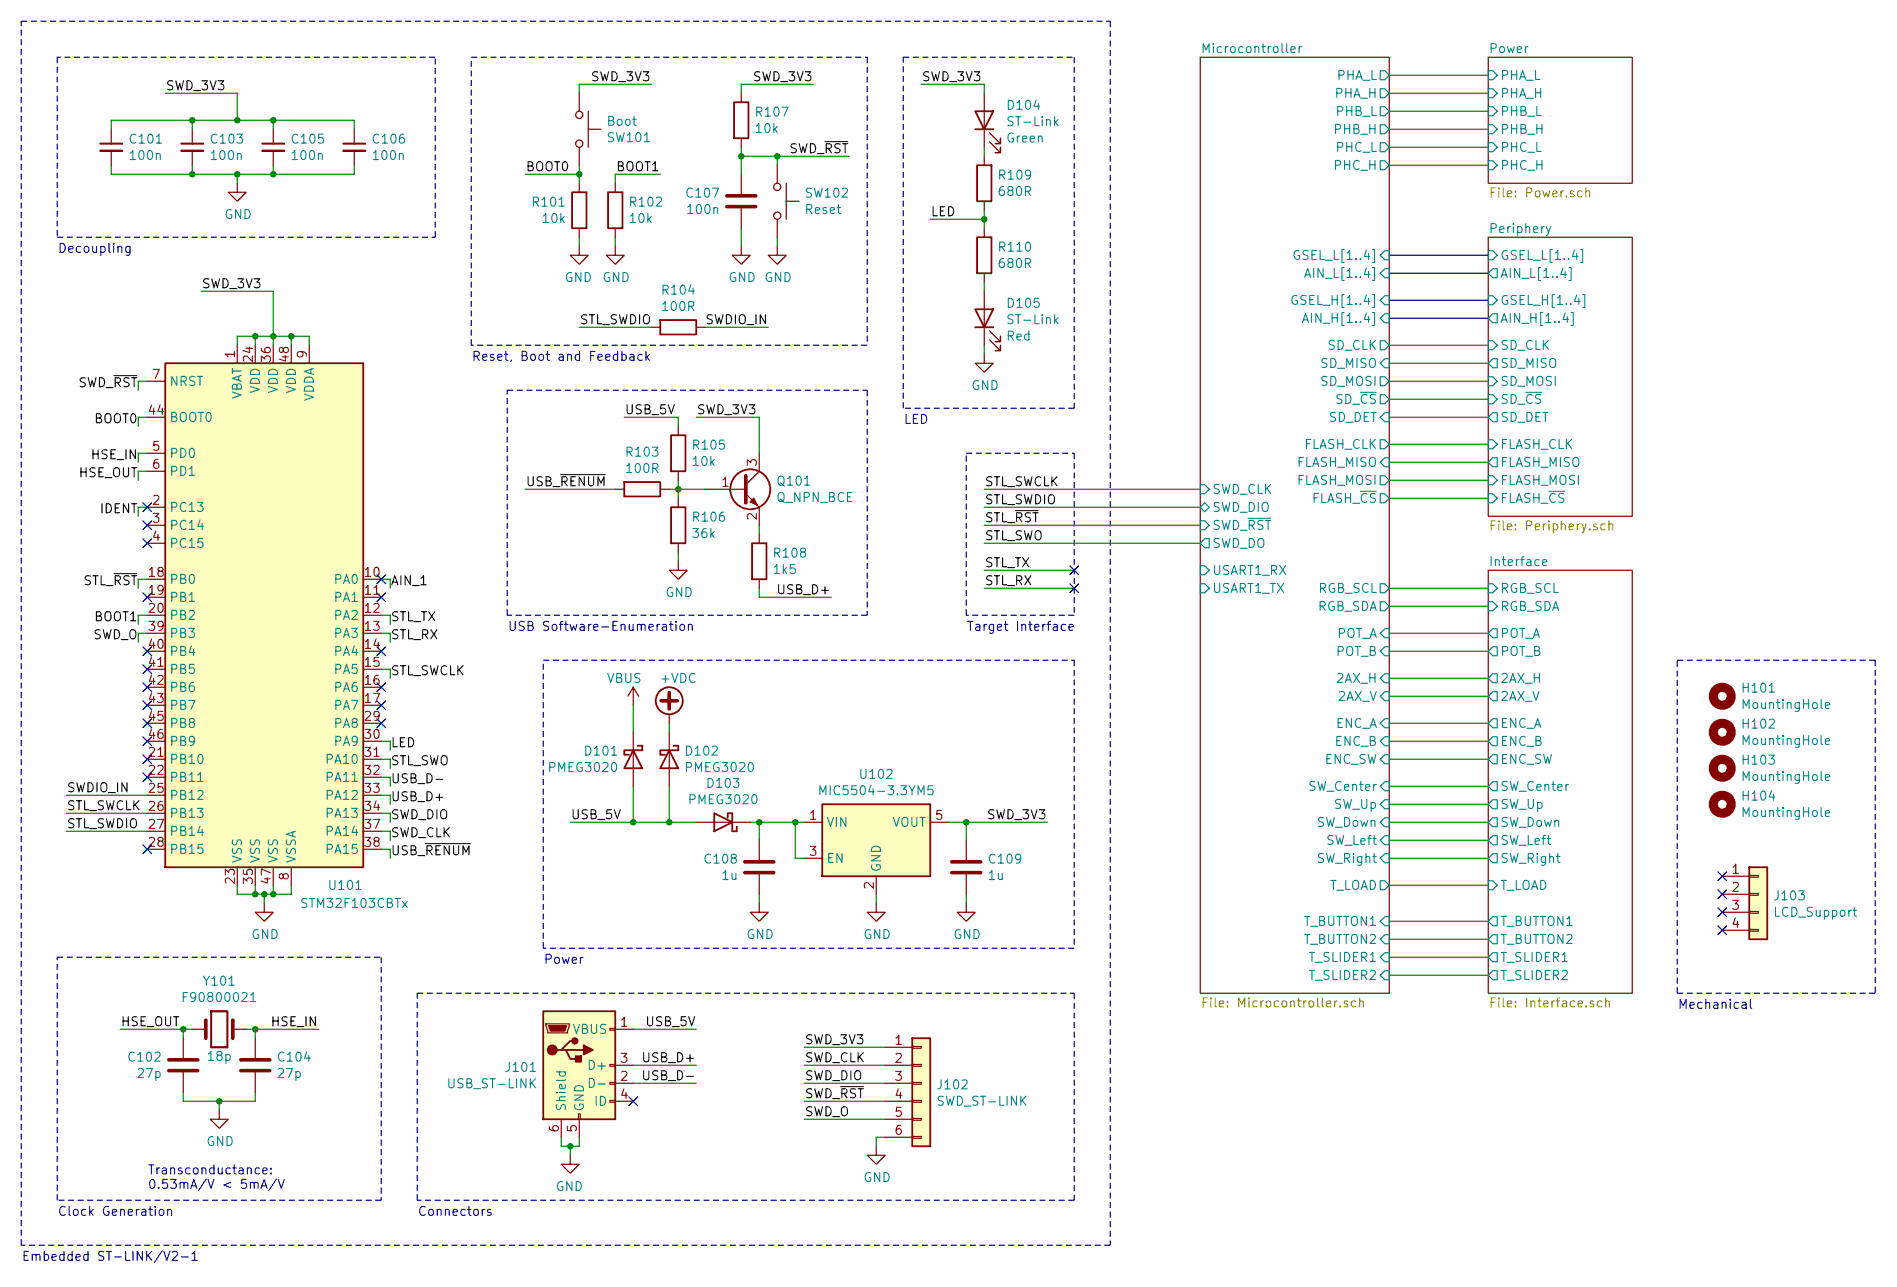
[picture p21: schematic STM32-Evalboard.sch, glaL2 STM32-Evalboard]

Parts:
C101, C103, C105, C106, C107: 100n; C_0603_1608Metric_Pad1.05x0.95mm_HandSolder
C102, C104: 27p; C_0603_1608Metric_Pad1.05x0.95mm_HandSolder
C108, C109: 1u; C_0603_1608Metric_Pad1.05x0.95mm_HandSolder
D101, D102, D103: PMEG3020; D_SOD-123
D104, D105: ST-Link; LED_0603_1608Metric_Castellated
H101, H102, H103, H104: MountingHole; MountingHole_3mm
J101: USB_ST-LINK; MicroUSB_GCT
J102: SWD_ST-LINK; PinSocket_Samtec_SMH_1x06_P2.54mm
J103: LCD_Support; PinSocket_1x04_P2.54mm_Display
Q101: Q_NPN_BCE; SOT-23
R101, R102, R105, R107: 10k; R_0603_1608Metric_Pad0.98x0.95mm_HandSolder
R103, R104: 100R; R_0603_1608Metric_Pad0.98x0.95mm_HandSolder
R106: 36k; R_0603_1608Metric_Pad0.98x0.95mm_HandSolder
R108: 1k5; R_0603_1608Metric_Pad0.98x0.95mm_HandSolder
R109, R110: 680R; R_0603_1608Metric_Pad0.98x0.95mm_HandSolder
SW101: Boot; Button_KMR4
SW102: Reset; Button_KMR4
U101: STM32F103CBTx; LQFP-48_7x7mm_P0.5mm
U102: MIC5504-3.3YM5; SOT-23-5
Y101: F90800021; Crystal_SMD_5032-2Pin_5.0x3.2mm

Connections:
+VDC: D102.1 (K); also elsewhere on the board
/BOOT0: R101.1, SW101.1, U101.44 (BOOT0)
/BOOT1: R102.1, U101.20 (PB2)
/HSE_IN: C104.1, U101.5 (PD0), Y101.2
/HSE_OUT: C102.1, U101.6 (PD1), Y101.1
/LED: R109.1, R110.1, U101.30 (PA9)
/STL_SWCLK: U101.15 (PA5), U101.26 (PB13); also elsewhere on the board
/STL_SWDIO: R104.2, U101.27 (PB14); also elsewhere on the board
/STL_SWO: U101.31 (PA10); also elsewhere on the board
/STL_~RST: U101.18 (PB0); also elsewhere on the board
/SWDIO_IN: R104.1, U101.25 (PB12)
/SWD_3V3: C101.1, C103.1, C105.1, C106.1, C109.1, D104.2 (A), J102.1, Q101.3 (C), R107.1, SW101.2, U101.1 (VBAT), U101.9 (VDDA), U101.24 (VDD), U101.36 (VDD), U101.48 (VDD), U102.5 (VOUT)
/SWD_CLK: J102.2, U101.37 (PA14)
/SWD_DIO: J102.3, U101.34 (PA13)
/SWD_O: J102.5, U101.39 (PB3)
/SWD_~RST: C107.1, J102.4, R107.2, SW102.1, U101.7 (NRST)
/USB_5V: D101.2 (A), D102.2 (A), D103.2 (A), J101.1 (VBUS), R105.1
/USB_D+: J101.3 (D+), R108.2, U101.33 (PA12)
/USB_D-: J101.2 (D-), U101.32 (PA11)
/USB_~RENUM: R103.2, U101.38 (PA15)
GND: C101.2, C102.2, C103.2, C104.2, C105.2, C106.2, C107.2, C108.2, C109.2, D105.1 (K), J101.5 (GND), J101.6 (Shield), J102.6, R101.2, R102.2, R106.2, SW102.2, U101.8 (VSSA), U101.23 (VSS), U101.35 (VSS), U101.47 (VSS), U102.2 (GND); also elsewhere on the board
unnamed: C108.1, D103.1 (K), U102.1 (VIN), U102.3 (EN)
unnamed: D104.1 (K), R109.2
unnamed: D105.2 (A), R110.2
unnamed: Q101.1 (B), R103.1, R105.2, R106.1
unnamed: Q101.2 (E), R108.1
VBUS: D101.1 (K); also elsewhere on the board

Notes on the sheet:
Reset, Boot and Feedback
Connectors
Embedded ST-LINK/V2-1
Power
USB Software-Enumeration
Decoupling
LED
Transconductance: 0.53mA/V < 5mA/V
Clock Generation
Target Interface
Mechanical

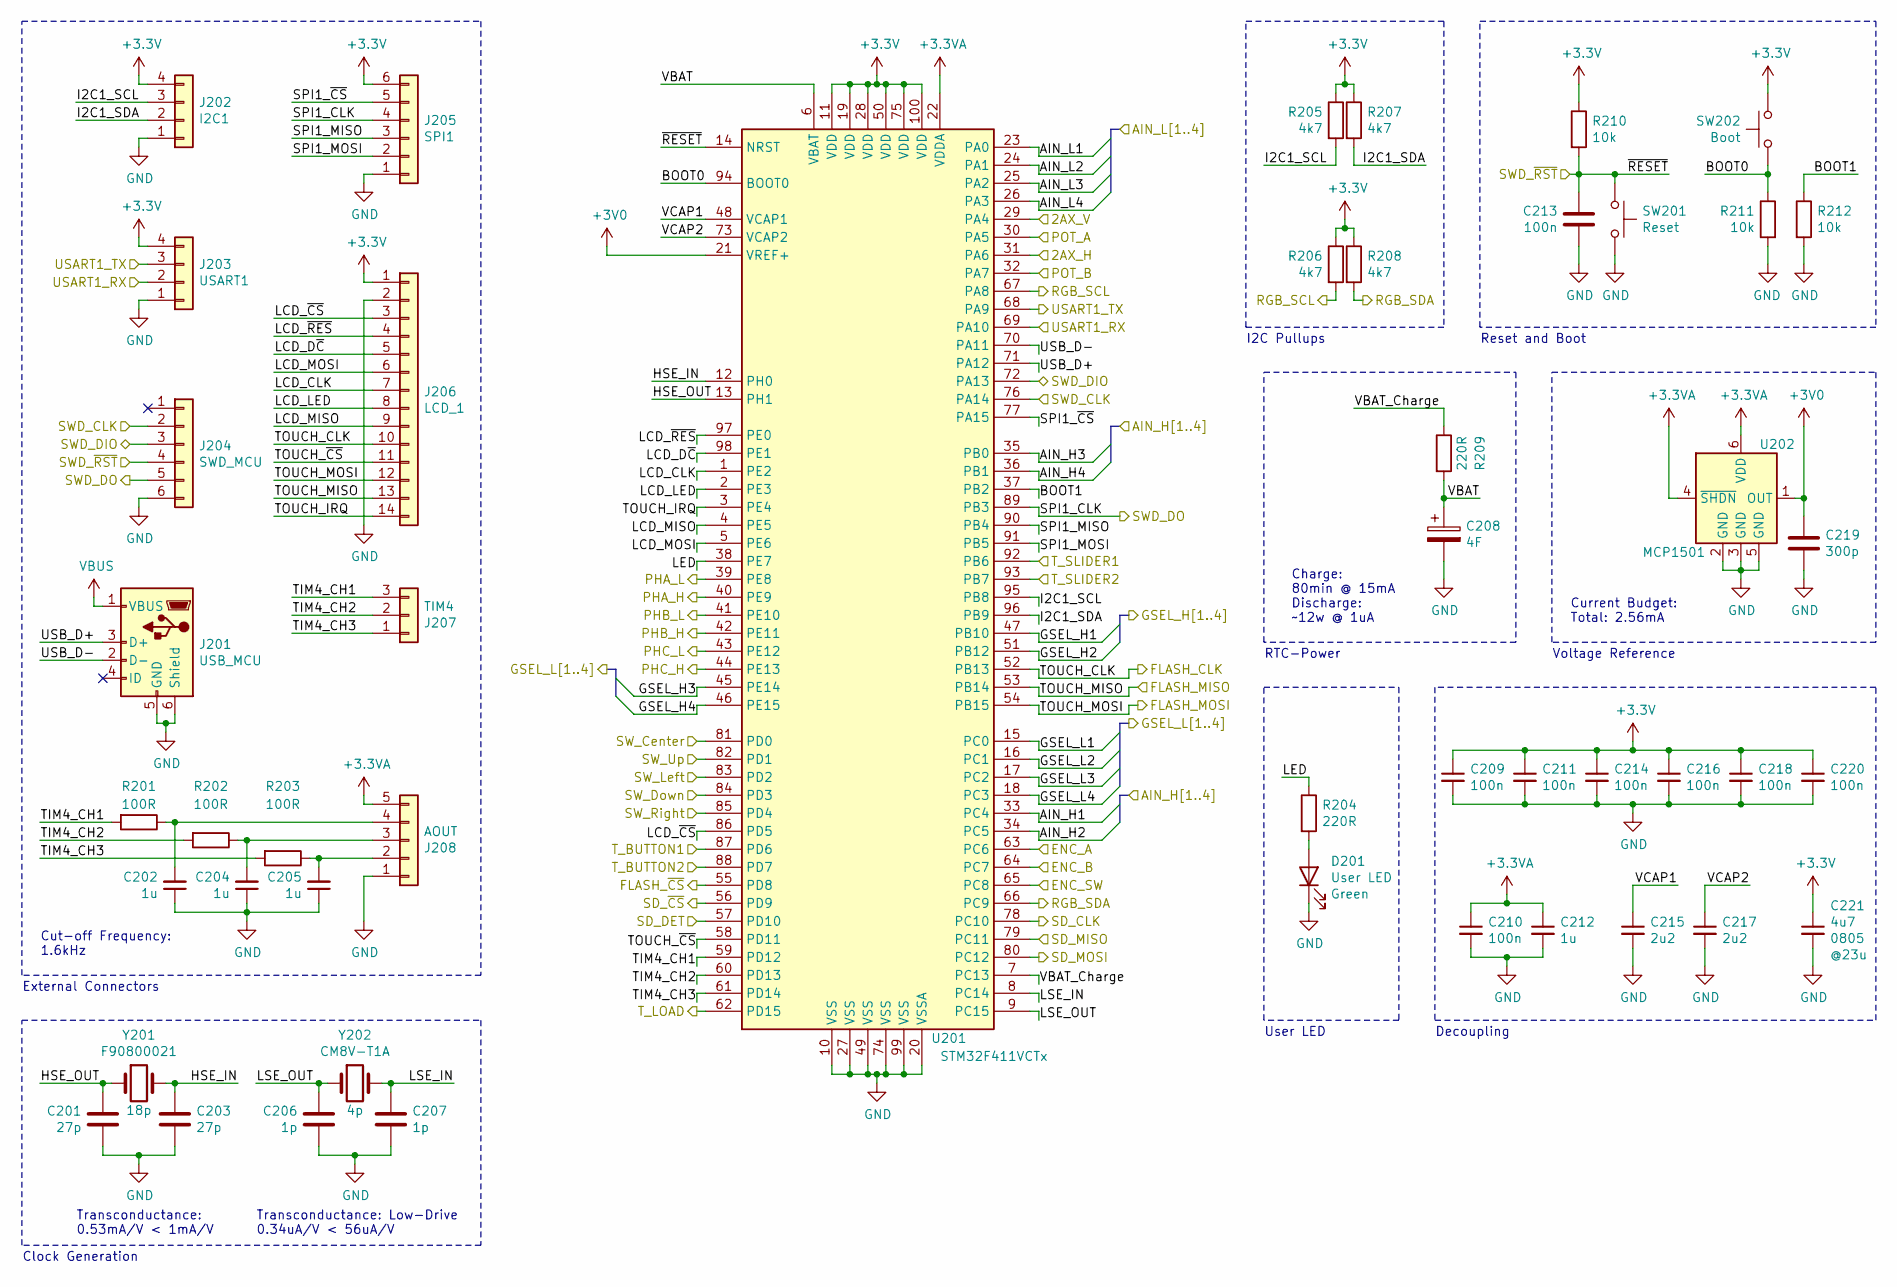
[picture p22: schematic Microcontroller.sch, glaL2 STM32-Evalboard]

Parts:
C201, C203: 27p; C_0603_1608Metric_Pad1.05x0.95mm_HandSolder
C202, C204, C205, C212: 1u; C_0603_1608Metric_Pad1.05x0.95mm_HandSolder
C206, C207: 1p; C_0603_1608Metric_Pad1.05x0.95mm_HandSolder
C208: 4F; SuperCap_196_HVC
C209, C210, C211, C213, C214, C216, C218, C220: 100n; C_0603_1608Metric_Pad1.05x0.95mm_HandSolder
C215, C217: 2u2; C_0603_1608Metric_Pad1.05x0.95mm_HandSolder
C219: 300p; C_0603_1608Metric_Pad1.05x0.95mm_HandSolder
C221: 4u7; C_0805_2012Metric_Pad1.15x1.40mm_HandSolder
D201: User LED; LED_0603_1608Metric_Castellated
J201: USB_MCU; MicroUSB_GCT
J202: I2C1; PinSocket_Samtec_SMH_1x04_P2.54mm
J203: USART1; PinSocket_Samtec_SMH_1x04_P2.54mm
J204: SWD_MCU; PinSocket_Samtec_SMH_1x06_P2.54mm
J205: SPI1; PinSocket_Samtec_SMH_1x06_P2.54mm
J206: LCD_1; PinSocket_1x14_P2.54mm_Display
J207: TIM4; PinSocket_Samtec_SMH_1x03_P2.54mm
J208: AOUT; PinSocket_Samtec_SMH_1x05_P2.54mm
R201, R202, R203: 100R; R_0603_1608Metric_Pad0.98x0.95mm_HandSolder
R204, R209: 220R; R_0603_1608Metric_Pad0.98x0.95mm_HandSolder
R205, R206, R207, R208: 4k7; R_0603_1608Metric_Pad0.98x0.95mm_HandSolder
R210, R211, R212: 10k; R_0603_1608Metric_Pad0.98x0.95mm_HandSolder
SW201: Reset; Button_KMR4
SW202: Boot; Button_KMR4
U201: STM32F411VCTx; LQFP-100_14x14mm_P0.5mm
U202: MCP1501; SOT-23-6_Handsoldering
Y201: F90800021; Crystal_SMD_5032-2Pin_5.0x3.2mm
Y202: CM8V-T1A; Crystal_SMD_2012-2Pin_2.0x1.2mm_HandSoldering

Connections:
+3.3VA: C210.1, C212.1, J208.5, U201.22 (VDDA), U202.4 (~SHDN), U202.6 (VDD); also elsewhere on the board
+3V0: C219.1, U201.21 (VREF+), U202.1 (OUT); also elsewhere on the board
+3V3: C209.1, C211.1, C214.1, C216.1, C218.1, C220.1, C221.1, J202.4, J203.4, J205.6, J206.1, R205.1, R206.1, R207.1, R208.1, R210.1, SW202.1, U201.11 (VDD), U201.19 (VDD), U201.28 (VDD), U201.50 (VDD), U201.75 (VDD), U201.100 (VDD); also elsewhere on the board
/Interface/2AX_H: U201.31 (PA6); also elsewhere on the board
/Interface/2AX_V: U201.29 (PA4); also elsewhere on the board
/Interface/ENC_A: U201.63 (PC6); also elsewhere on the board
/Interface/ENC_B: U201.64 (PC7); also elsewhere on the board
/Interface/ENC_SW: U201.65 (PC8); also elsewhere on the board
/Interface/POT_A: U201.30 (PA5); also elsewhere on the board
/Interface/POT_B: U201.32 (PA7); also elsewhere on the board
/Interface/RGB_SCL: R206.2, U201.67 (PA8); also elsewhere on the board
/Interface/RGB_SDA: R208.2, U201.66 (PC9); also elsewhere on the board
/Interface/SW_Center: U201.81 (PD0); also elsewhere on the board
/Interface/SW_Down: U201.84 (PD3); also elsewhere on the board
/Interface/SW_Left: U201.83 (PD2); also elsewhere on the board
/Interface/SW_Right: U201.85 (PD4); also elsewhere on the board
/Interface/SW_Up: U201.82 (PD1); also elsewhere on the board
/Interface/T_BUTTON1: U201.87 (PD6); also elsewhere on the board
/Interface/T_BUTTON2: U201.88 (PD7); also elsewhere on the board
/Interface/T_LOAD: U201.62 (PD15); also elsewhere on the board
/Interface/T_SLIDER1: U201.92 (PB6); also elsewhere on the board
/Interface/T_SLIDER2: U201.93 (PB7); also elsewhere on the board
/Microcontroller/AIN_H1: U201.33 (PC4); also elsewhere on the board
/Microcontroller/AIN_H2: U201.34 (PC5); also elsewhere on the board
/Microcontroller/AIN_H3: U201.35 (PB0); also elsewhere on the board
/Microcontroller/AIN_H4: U201.36 (PB1); also elsewhere on the board
/Microcontroller/AIN_L1: U201.23 (PA0); also elsewhere on the board
/Microcontroller/AIN_L2: U201.24 (PA1); also elsewhere on the board
/Microcontroller/AIN_L3: U201.25 (PA2); also elsewhere on the board
/Microcontroller/AIN_L4: U201.26 (PA3); also elsewhere on the board
/Microcontroller/BOOT0: R211.1, SW202.2, U201.94 (BOOT0)
/Microcontroller/BOOT1: R212.1, U201.37 (PB2)
/Microcontroller/FLASH_CLK: J206.10, U201.52 (PB13); also elsewhere on the board
/Microcontroller/FLASH_MISO: J206.13, U201.53 (PB14); also elsewhere on the board
/Microcontroller/FLASH_MOSI: J206.12, U201.54 (PB15); also elsewhere on the board
/Microcontroller/FLASH_~CS: U201.55 (PD8); also elsewhere on the board
/Microcontroller/GSEL_H1: U201.47 (PB10); also elsewhere on the board
/Microcontroller/GSEL_H2: U201.51 (PB12); also elsewhere on the board
/Microcontroller/GSEL_H3: U201.45 (PE14); also elsewhere on the board
/Microcontroller/GSEL_H4: U201.46 (PE15); also elsewhere on the board
/Microcontroller/GSEL_L1: U201.15 (PC0); also elsewhere on the board
/Microcontroller/GSEL_L2: U201.16 (PC1); also elsewhere on the board
/Microcontroller/GSEL_L3: U201.17 (PC2); also elsewhere on the board
/Microcontroller/GSEL_L4: U201.18 (PC3); also elsewhere on the board
/Microcontroller/HSE_IN: C203.1, U201.12 (PH0), Y201.2
/Microcontroller/HSE_OUT: C201.1, U201.13 (PH1), Y201.1
/Microcontroller/I2C1_SCL: J202.3, R205.2, U201.95 (PB8)
/Microcontroller/I2C1_SDA: J202.2, R207.2, U201.96 (PB9)
/Microcontroller/LCD_CLK: J206.7, U201.1 (PE2)
/Microcontroller/LCD_D~C: J206.5, U201.98 (PE1)
/Microcontroller/LCD_LED: J206.8, U201.2 (PE3)
/Microcontroller/LCD_MISO: J206.9, U201.4 (PE5)
/Microcontroller/LCD_MOSI: J206.6, U201.5 (PE6)
/Microcontroller/LCD_~CS: J206.3, U201.86 (PD5)
/Microcontroller/LCD_~RES: J206.4, U201.97 (PE0)
/Microcontroller/LED: R204.1, U201.38 (PE7)
/Microcontroller/LSE_IN: C207.1, U201.8 (PC14), Y202.2
/Microcontroller/LSE_OUT: C206.1, U201.9 (PC15), Y202.1
/Microcontroller/PHA_H: U201.40 (PE9); also elsewhere on the board
/Microcontroller/PHA_L: U201.39 (PE8); also elsewhere on the board
/Microcontroller/PHB_H: U201.42 (PE11); also elsewhere on the board
/Microcontroller/PHB_L: U201.41 (PE10); also elsewhere on the board
/Microcontroller/PHC_H: U201.44 (PE13); also elsewhere on the board
/Microcontroller/PHC_L: U201.43 (PE12); also elsewhere on the board
/Microcontroller/SD_CLK: U201.78 (PC10); also elsewhere on the board
/Microcontroller/SD_DET: U201.57 (PD10); also elsewhere on the board
/Microcontroller/SD_MISO: U201.79 (PC11); also elsewhere on the board
/Microcontroller/SD_MOSI: U201.80 (PC12); also elsewhere on the board
/Microcontroller/SD_~CS: U201.56 (PD9); also elsewhere on the board
/Microcontroller/SPI1_MISO: J205.3, U201.90 (PB4)
/Microcontroller/SPI1_MOSI: J205.2, U201.91 (PB5)
/Microcontroller/SPI1_~CS: J205.5, U201.77 (PA15)
/Microcontroller/TIM4_CH1: J207.3, R201.2, U201.59 (PD12)
/Microcontroller/TIM4_CH2: J207.2, R202.2, U201.60 (PD13)
/Microcontroller/TIM4_CH3: J207.1, R203.2, U201.61 (PD14)
/Microcontroller/TOUCH_IRQ: J206.14, U201.3 (PE4)
/Microcontroller/TOUCH_~CS: J206.11, U201.58 (PD11)
/Microcontroller/USART1_RX: J203.2, U201.69 (PA10)
/Microcontroller/USART1_TX: J203.3, U201.68 (PA9)
/Microcontroller/USB_D+: J201.3 (D+), U201.71 (PA12)
/Microcontroller/USB_D-: J201.2 (D-), U201.70 (PA11)
/Microcontroller/VBAT: C208.1, R209.2, U201.6 (VBAT)
/Microcontroller/VBAT_Charge: R209.1, U201.7 (PC13)
/Microcontroller/VCAP1: C215.1, U201.48 (VCAP1)
/Microcontroller/VCAP2: C217.1, U201.73 (VCAP2)
/STL_SWCLK: J204.2, U201.76 (PA14); also elsewhere on the board
/STL_SWDIO: J204.3, U201.72 (PA13); also elsewhere on the board
/STL_SWO: J204.5, J205.4, U201.89 (PB3); also elsewhere on the board
/STL_~RST: C213.1, J204.4, R210.2, SW201.1, U201.14 (NRST); also elsewhere on the board
GND: C201.2, C202.1, C203.2, C204.1, C205.1, C206.2, C207.2, C208.2, C209.2, C210.2, C211.2, C212.2, C213.2, C214.2, C215.2, C216.2, C217.2, C218.2, C219.2, C220.2, C221.2, D201.1 (K), J201.5 (GND), J201.6 (Shield), J202.1, J203.1, J204.6, J205.1, J206.2, J208.1, R211.2, R212.2, SW201.2, U201.10 (VSS), U201.20 (VSSA), U201.27 (VSS), U201.49 (VSS), U201.74 (VSS), U201.99 (VSS), U202.2 (GND), U202.3 (GND), U202.5 (GND); also elsewhere on the board
unnamed: C202.2, J208.4, R201.1
unnamed: C204.2, J208.3, R202.1
unnamed: C205.2, J208.2, R203.1
unnamed: D201.2 (A), R204.2
VBUS: J201.1 (VBUS); also elsewhere on the board

Notes on the sheet:
External Connectors
Decoupling
Charge: 80min @ 15mA Discharge: ~~12w @ 1uA
Clock Generation
Transconductance: 0.53mA/V < 1mA/V
Transconductance: Low-Drive 0.34uA/V < 56uA/V
Current Budget: Total: 2.56mA
Voltage Reference
Cut-off Frequency: 1.6kHz
User LED
RTC-Power
I2C Pullups
Reset and Boot

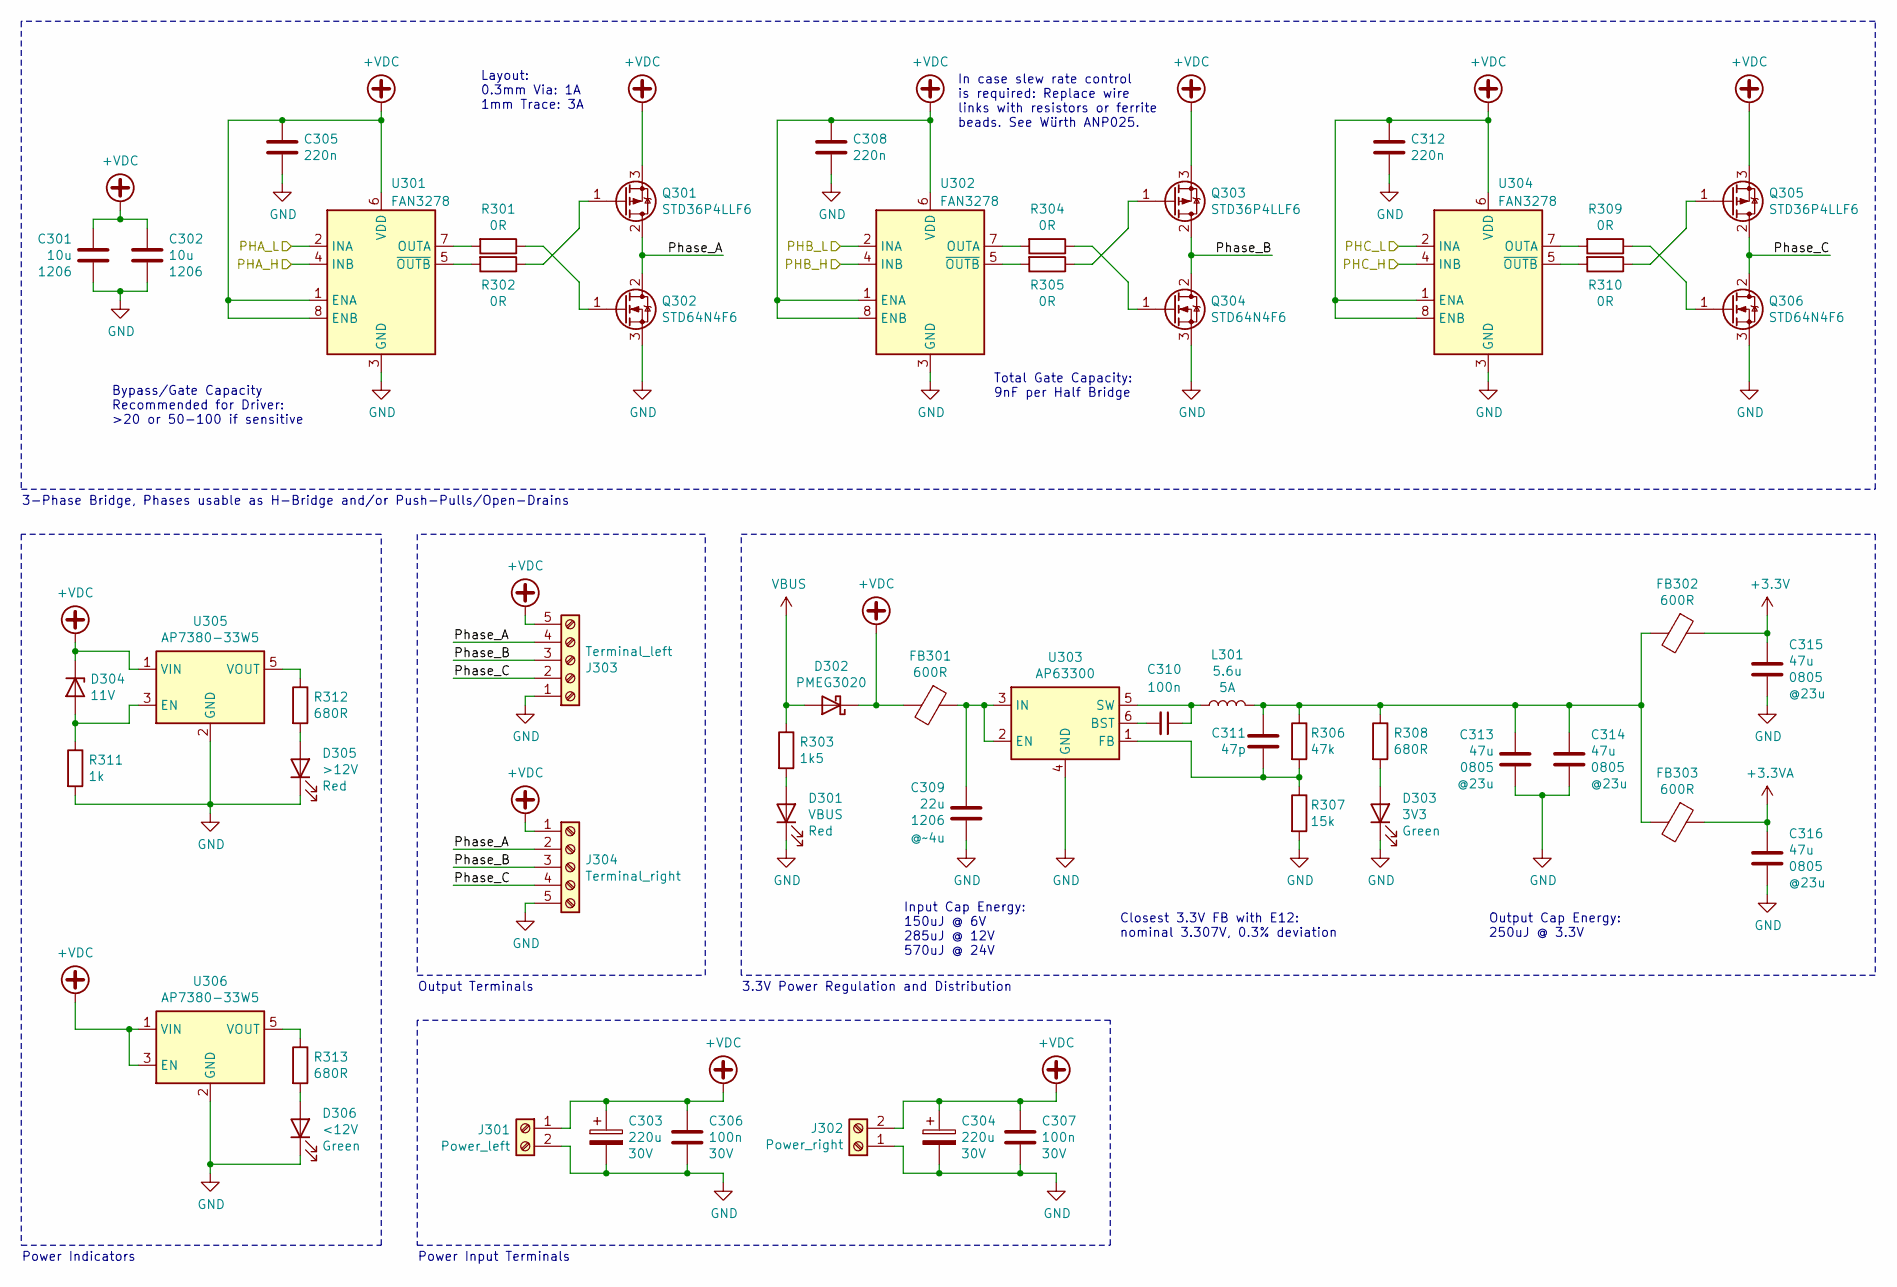
[picture p23: schematic Power.sch, glaL2 STM32-Evalboard]

Parts:
C301, C302: 10u; C_1206_3216Metric_Pad1.33x1.80mm_HandSolder
C303, C304: 220u; CP_Radial_D10.0mm_P5.00mm; Voltage 30V
C305, C308, C312: 220n; C_0603_1608Metric_Pad1.05x0.95mm_HandSolder
C306, C307: 100n; C_0603_1608Metric_Pad1.05x0.95mm_HandSolder; Voltage 30V
C309: 22u; C_1206_3216Metric_Pad1.33x1.80mm_HandSolder
C310: 100n; C_0603_1608Metric_Pad1.05x0.95mm_HandSolder
C311: 47p; C_0603_1608Metric_Pad1.05x0.95mm_HandSolder
C313, C314, C315, C316: 47u; C_0805_2012Metric_Pad1.15x1.40mm_HandSolder
D301: VBUS; LED_0603_1608Metric_Castellated
D302: PMEG3020; D_SOD-123
D303: 3V3; LED_0603_1608Metric_Castellated
D304: 11V; R_0603_1608Metric_Pad0.98x0.95mm_HandSolder
D305: >12V; LED_0603_1608Metric_Castellated
D306: <12V; LED_0603_1608Metric_Castellated
FB301, FB302, FB303: 600R; R_0805_2012Metric_Pad1.15x1.40mm_HandSolder
J301: Power_left; TerminalBlock_Amphenol_1x02_P3.50mm
J302: Power_right; TerminalBlock_Amphenol_1x02_P3.50mm
J303: Terminal_left; TerminalBlock_Amphenol_1x05_P3.50mm
J304: Terminal_right; TerminalBlock_Amphenol_1x05_P3.50mm
L301: 5.6u; Inductor_7.2x6.65x3.0mm
Q301, Q303, Q305: STD36P4LLF6; TO-252-2
Q302, Q304, Q306: STD64N4F6; TO-252-2
R301, R302, R304, R305, R309, R310: 0R; R_0603_1608Metric_Pad0.98x0.95mm_HandSolder
R303: 1k5; R_0603_1608Metric_Pad0.98x0.95mm_HandSolder
R306: 47k; R_0603_1608Metric_Pad0.98x0.95mm_HandSolder
R307: 15k; R_0603_1608Metric_Pad0.98x0.95mm_HandSolder
R308, R312, R313: 680R; R_0603_1608Metric_Pad0.98x0.95mm_HandSolder
R311: 1k; R_0603_1608Metric_Pad0.98x0.95mm_HandSolder
U301, U302, U304: FAN3278; SOIC-8_3.9x4.9mm_P1.27mm
U303: AP63300; TSOT-23-6
U305, U306: AP7380-33W5; SOT-23-5

Connections:
+3.3VA: C316.2, FB303.1; also elsewhere on the board
+3V3: C315.2, FB302.1; also elsewhere on the board
+VDC: C301.1, C302.1, C303.1, C304.1, C305.1, C306.1, C307.1, C308.1, C312.1, D302.1 (K), D304.1 (K), FB301.2, J301.1, J302.2, J303.5, J304.1, Q301.3 (S), Q303.3 (S), Q305.3 (S), U301.1 (ENA), U301.6 (VDD), U301.8 (ENB), U302.1 (ENA), U302.6 (VDD), U302.8 (ENB), U304.1 (ENA), U304.6 (VDD), U304.8 (ENB), U305.1 (VIN), U306.1 (VIN), U306.3 (EN); also elsewhere on the board
/Microcontroller/PHA_H: U301.4 (INB); also elsewhere on the board
/Microcontroller/PHA_L: U301.2 (INA); also elsewhere on the board
/Microcontroller/PHB_H: U302.4 (INB); also elsewhere on the board
/Microcontroller/PHB_L: U302.2 (INA); also elsewhere on the board
/Microcontroller/PHC_H: U304.4 (INB); also elsewhere on the board
/Microcontroller/PHC_L: U304.2 (INA); also elsewhere on the board
/Power/Phase_A: J303.4, J304.2, Q301.2 (D), Q302.2 (D)
/Power/Phase_B: J303.3, J304.3, Q303.2 (D), Q304.2 (D)
/Power/Phase_C: J303.2, J304.4, Q305.2 (D), Q306.2 (D)
GND: C301.2, C302.2, C303.2, C304.2, C305.2, C306.2, C307.2, C308.2, C309.2, C312.2, C313.2, C314.2, C315.1, C316.1, D301.1 (K), D303.1 (K), D305.1 (K), D306.1 (K), J301.2, J302.1, J303.1, J304.5, Q302.3 (S), Q304.3 (S), Q306.3 (S), R307.2, R311.2, U301.3 (GND), U302.3 (GND), U303.4 (GND), U304.3 (GND), U305.2 (GND), U306.2 (GND); also elsewhere on the board
unnamed: C309.1, FB301.1, U303.2 (EN), U303.3 (IN)
unnamed: C310.1, L301.1, U303.5 (SW)
unnamed: C310.2, U303.6 (BST)
unnamed: C311.1, C313.1, C314.1, FB302.2, FB303.2, L301.2, R306.1, R308.1
unnamed: C311.2, R306.2, R307.1, U303.1 (FB)
unnamed: D301.2 (A), R303.2
unnamed: D303.2 (A), R308.2
unnamed: D304.2 (A), R311.1, U305.3 (EN)
unnamed: D305.2 (A), R312.2
unnamed: D306.2 (A), R313.2
unnamed: Q301.1 (G), R302.1
unnamed: Q302.1 (G), R301.1
unnamed: Q303.1 (G), R305.1
unnamed: Q304.1 (G), R304.1
unnamed: Q305.1 (G), R310.1
unnamed: Q306.1 (G), R309.1
unnamed: R301.2, U301.7 (OUTA)
unnamed: R302.2, U301.5 (~OUTB~)
unnamed: R304.2, U302.7 (OUTA)
unnamed: R305.2, U302.5 (~OUTB~)
unnamed: R309.2, U304.7 (OUTA)
unnamed: R310.2, U304.5 (~OUTB~)
unnamed: R312.1, U305.5 (VOUT)
unnamed: R313.1, U306.5 (VOUT)
VBUS: D302.2 (A), R303.1; also elsewhere on the board

Notes on the sheet:
3-Phase Bridge, Phases usable as H-Bridge and/or Push-Pulls/Open-Drains
Layout: 0.3mm Via: 1A 1mm Trace: 3A
In case slew rate control is required: Replace wire links with resistors or ferrite beads. See Würth ANP025.
Total Gate Capacity: 9nF per Half Bridge
Bypass/Gate Capacity Recommended for Driver: >20 or 50-100 if sensitive
Input Cap Energy: 150uJ @ 6V 285uJ @ 12V 570uJ @ 24V
Output Cap Energy: 250uJ @ 3.3V
3.3V Power Regulation and Distribution
Closest 3.3V FB with E12: nominal 3.307V, 0.3% deviation
Power Input Terminals
Output Terminals
Power Indicators

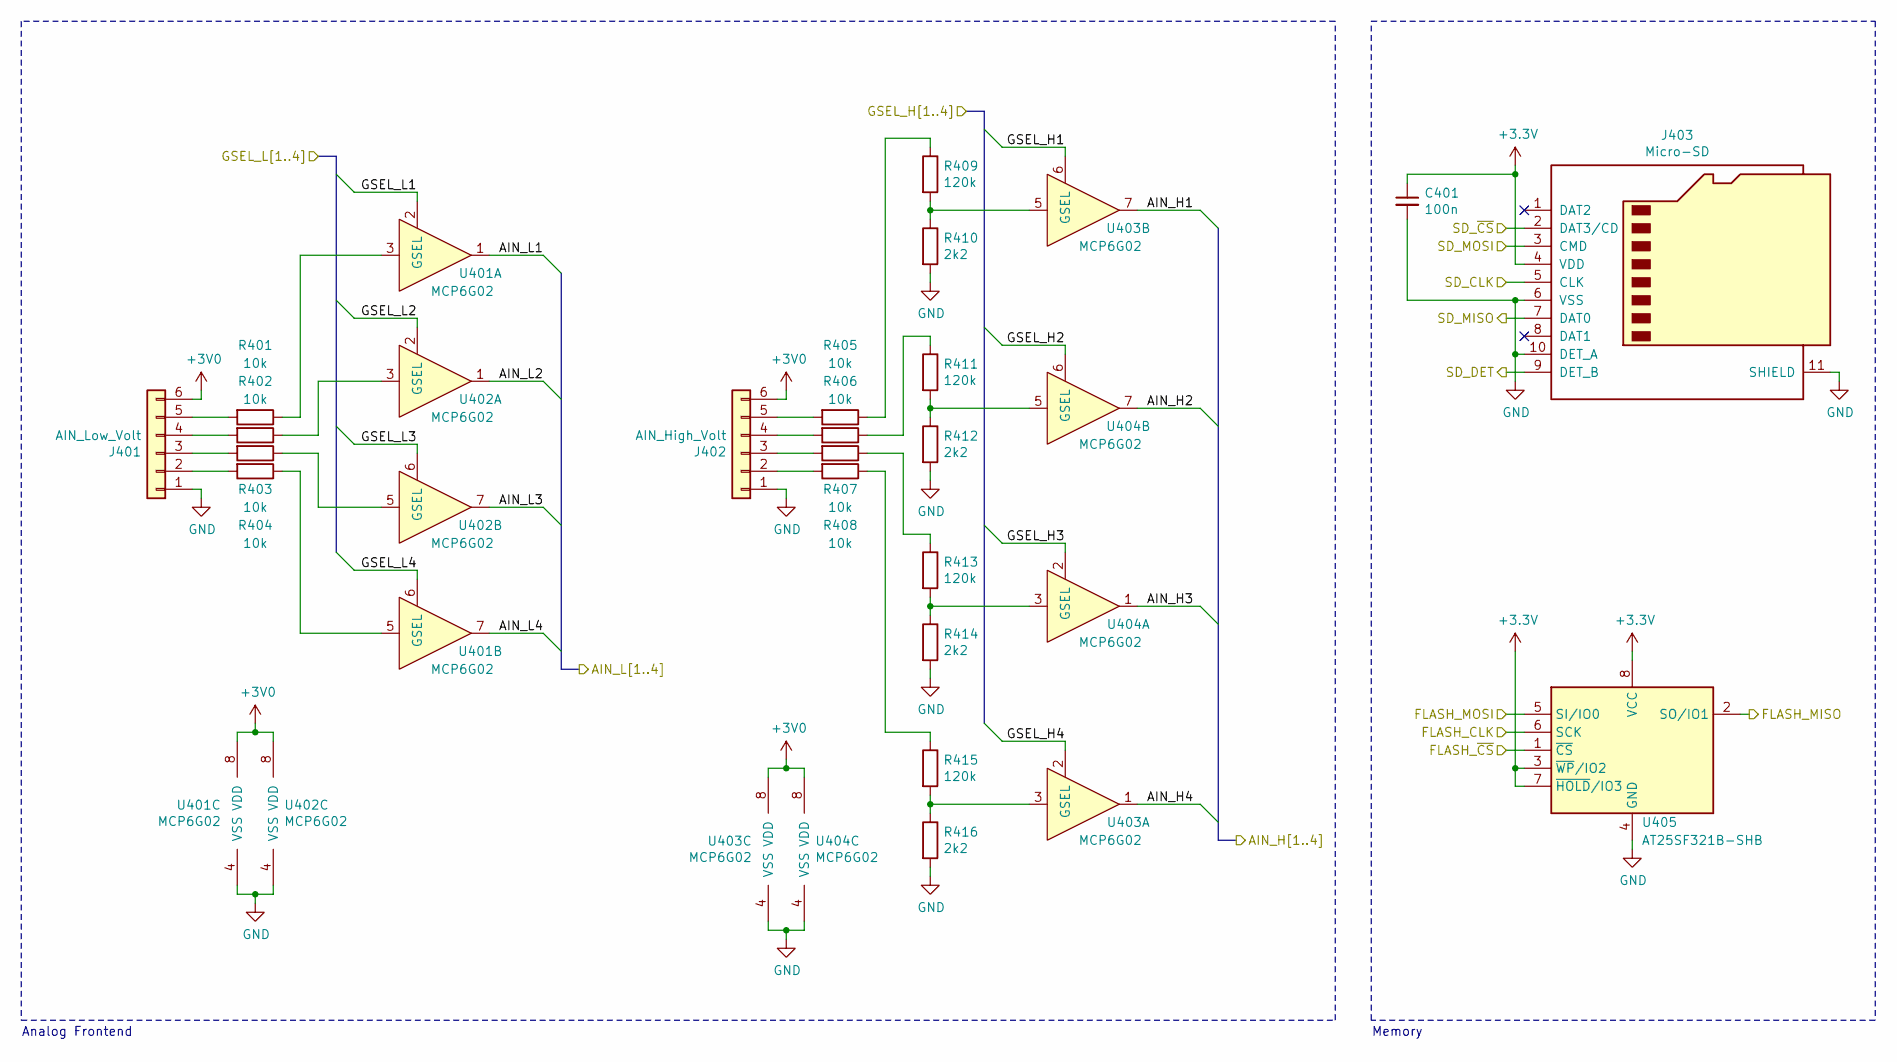
[picture p24: schematic Periphery.sch, glaL2 STM32-Evalboard]

Parts:
C401: 100n; C_0603_1608Metric_Pad1.05x0.95mm_HandSolder
J401: AIN_Low_Volt; PinSocket_Samtec_SMH_1x06_P2.54mm
J402: AIN_High_Volt; PinSocket_Samtec_SMH_1x06_P2.54mm
J403: Micro-SD; MicroSD_Molex
R401, R402, R403, R404, R405, R406, R407, R408: 10k; R_0603_1608Metric_Pad0.98x0.95mm_HandSolder
R409, R411, R413, R415: 120k; R_0603_1608Metric_Pad0.98x0.95mm_HandSolder
R410, R412, R414, R416: 2k2; R_0603_1608Metric_Pad0.98x0.95mm_HandSolder
U401, U402, U403, U404: MCP6G02; MSOP-8_3x3mm_P0.65mm
U405: AT25SF321B-SHB; SOIC-8_3.9x4.9mm_P1.27mm

Connections:
+3V0: J401.6, J402.6, U401.8 (VDD), U402.8 (VDD), U403.8 (VDD), U404.8 (VDD); also elsewhere on the board
+3V3: C401.1, J403.4 (VDD), U405.3 (~WP~/IO2), U405.7 (~HOLD~/IO3), U405.8 (VCC); also elsewhere on the board
/Microcontroller/AIN_H1: U403.7; also elsewhere on the board
/Microcontroller/AIN_H2: U404.7; also elsewhere on the board
/Microcontroller/AIN_H3: U404.1; also elsewhere on the board
/Microcontroller/AIN_H4: U403.1; also elsewhere on the board
/Microcontroller/AIN_L1: U401.1; also elsewhere on the board
/Microcontroller/AIN_L2: U402.1; also elsewhere on the board
/Microcontroller/AIN_L3: U402.7; also elsewhere on the board
/Microcontroller/AIN_L4: U401.7; also elsewhere on the board
/Microcontroller/FLASH_CLK: U405.6 (SCK); also elsewhere on the board
/Microcontroller/FLASH_MISO: U405.2 (SO/IO1); also elsewhere on the board
/Microcontroller/FLASH_MOSI: U405.5 (SI/IO0); also elsewhere on the board
/Microcontroller/FLASH_~CS: U405.1 (~CS); also elsewhere on the board
/Microcontroller/GSEL_H1: U403.6 (GSEL); also elsewhere on the board
/Microcontroller/GSEL_H2: U404.6 (GSEL); also elsewhere on the board
/Microcontroller/GSEL_H3: U404.2 (GSEL); also elsewhere on the board
/Microcontroller/GSEL_H4: U403.2 (GSEL); also elsewhere on the board
/Microcontroller/GSEL_L1: U401.2 (GSEL); also elsewhere on the board
/Microcontroller/GSEL_L2: U402.2 (GSEL); also elsewhere on the board
/Microcontroller/GSEL_L3: U402.6 (GSEL); also elsewhere on the board
/Microcontroller/GSEL_L4: U401.6 (GSEL); also elsewhere on the board
/Microcontroller/SD_CLK: J403.5 (CLK); also elsewhere on the board
/Microcontroller/SD_DET: J403.9 (DET_B); also elsewhere on the board
/Microcontroller/SD_MISO: J403.7 (DAT0); also elsewhere on the board
/Microcontroller/SD_MOSI: J403.3 (CMD); also elsewhere on the board
/Microcontroller/SD_~CS: J403.2 (DAT3/CD); also elsewhere on the board
GND: C401.2, J401.1, J402.1, J403.6 (VSS), J403.10 (DET_A), J403.11 (SHIELD), R410.2, R412.2, R414.2, R416.2, U401.4 (VSS), U402.4 (VSS), U403.4 (VSS), U404.4 (VSS), U405.4 (GND); also elsewhere on the board
unnamed: J401.2, R404.2
unnamed: J401.3, R403.2
unnamed: J401.4, R402.2
unnamed: J401.5, R401.2
unnamed: J402.2, R408.2
unnamed: J402.3, R407.2
unnamed: J402.4, R406.2
unnamed: J402.5, R405.2
unnamed: R401.1, U401.3
unnamed: R402.1, U402.3
unnamed: R403.1, U402.5
unnamed: R404.1, U401.5
unnamed: R405.1, R409.1
unnamed: R406.1, R411.1
unnamed: R407.1, R413.1
unnamed: R408.1, R415.1
unnamed: R409.2, R410.1, U403.5
unnamed: R411.2, R412.1, U404.5
unnamed: R413.2, R414.1, U404.3
unnamed: R415.2, R416.1, U403.3

Notes on the sheet:
Analog Frontend
Memory
