jbussmann/glaL2-Leiterplatte/KiCad/STM32-Evalboard.kicad_pcb

## KiCad design KiCad/STM32-Evalboard.kicad_pcb (continued)

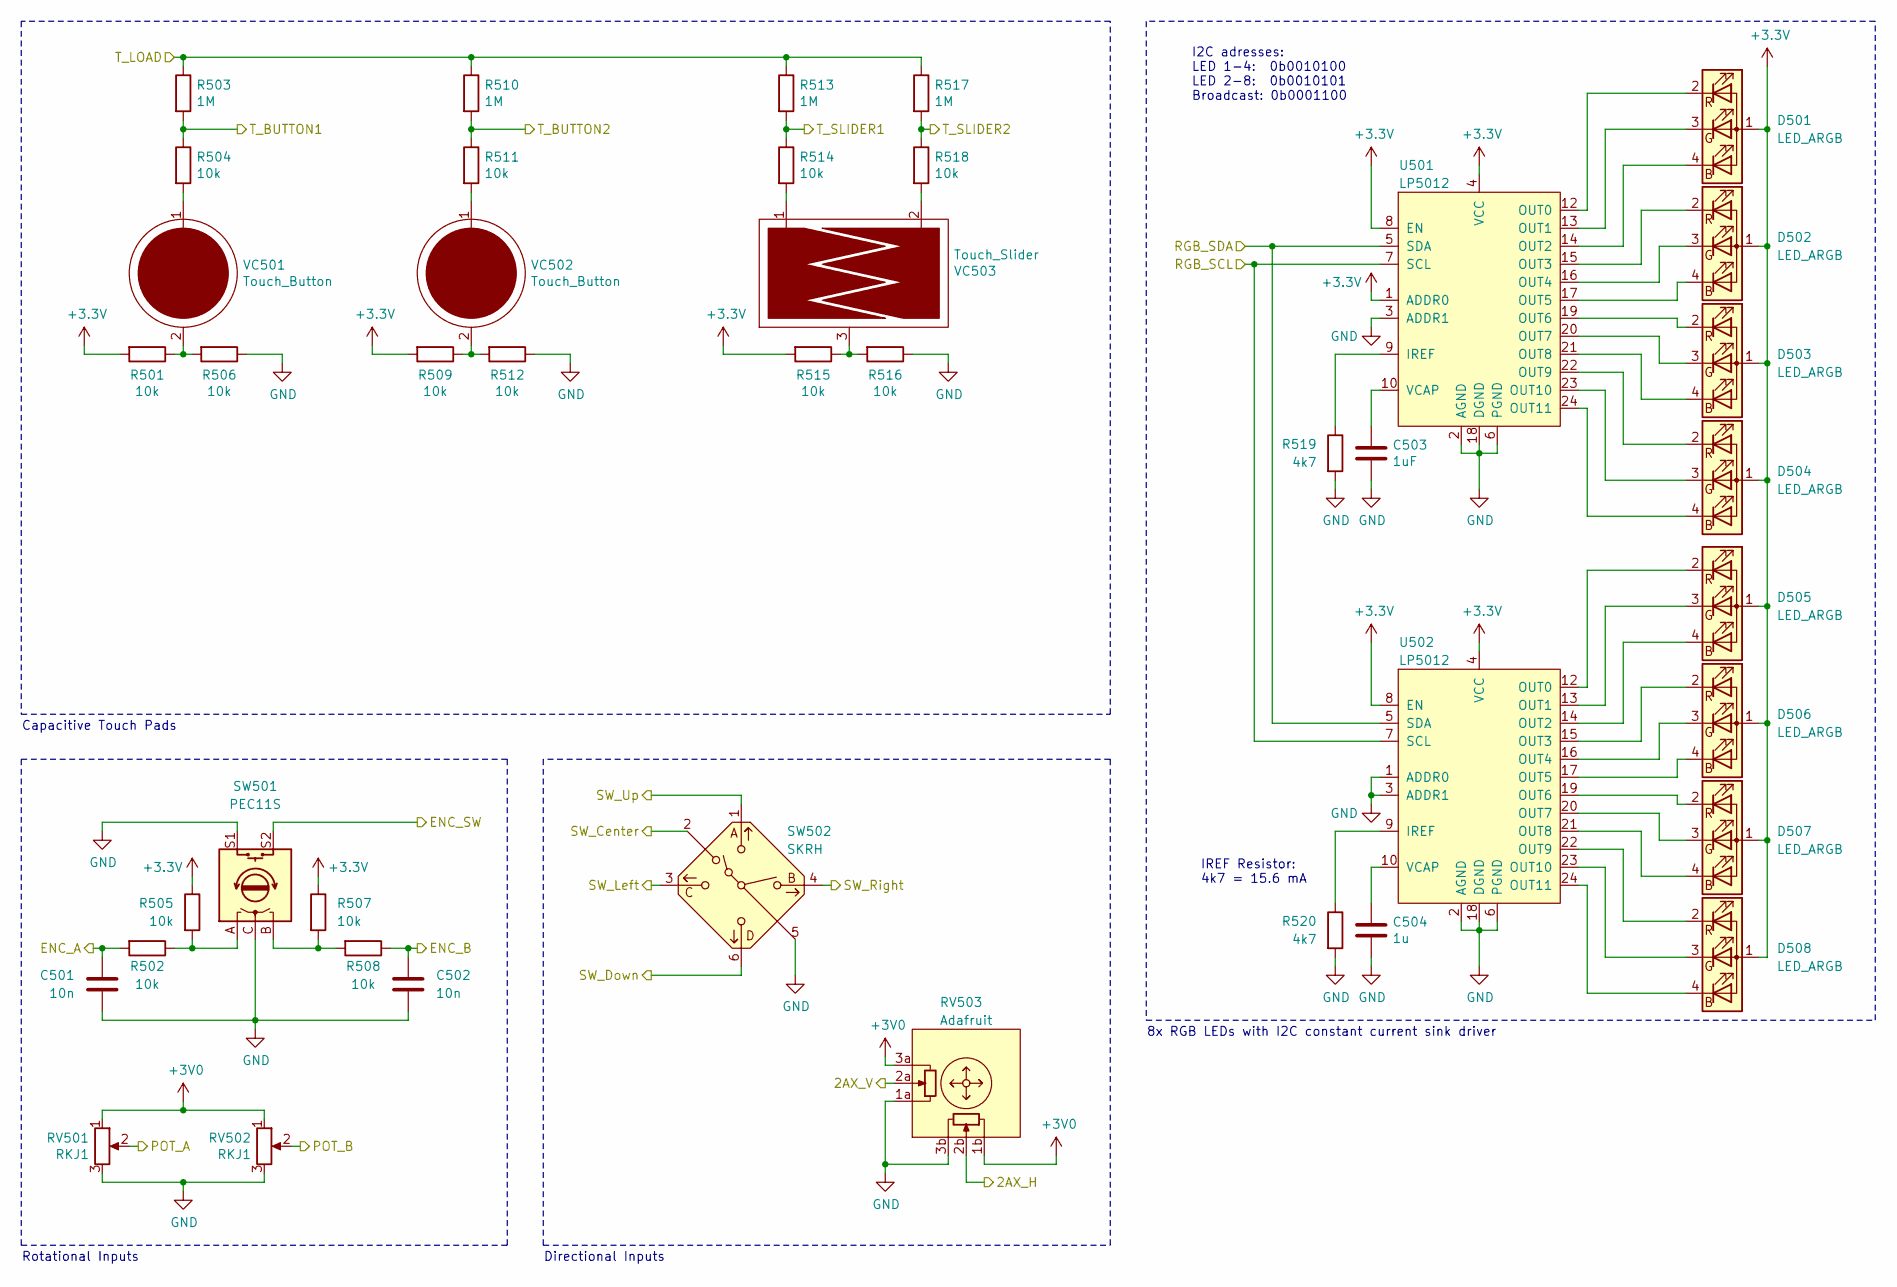
[picture p25: schematic Interface.sch, glaL2 STM32-Evalboard]

Parts:
C501, C502: 10n; C_0603_1608Metric_Pad1.05x0.95mm_HandSolder
C503: 1uF; C_0603_1608Metric_Pad1.05x0.95mm_HandSolder
C504: 1u; C_0603_1608Metric_Pad1.05x0.95mm_HandSolder
D501, D502, D503, D504, D505, D506, D507, D508: LED_ARGB; LED_PLCC4_3.2x2.8mm
R501, R502, R504, R505, R506, R507, R508, R509, R511, R512, R514, R515, R516, R518: 10k; R_0603_1608Metric_Pad0.98x0.95mm_HandSolder
R503, R510, R513, R517: 1M; R_0603_1608Metric_Pad0.98x0.95mm_HandSolder
R519, R520: 4k7; R_0603_1608Metric_Pad0.98x0.95mm_HandSolder
RV501, RV502: RKJ1; Potentiometer_Alps
RV503: Adafruit; Thumbstick_Adafruit
SW501: PEC11S; RotaryEncoder_Bourns
SW502: SKRH; MultiSwitch_Alps
U501, U502: LP5012; TSSOP-24_4.4x7.8mm_P0.65mm
VC501, VC502: Touch_Button
VC503: Touch_Slider

Connections:
+3V0: RV501.1, RV502.1, RV503.1b, RV503.3a; also elsewhere on the board
+3V3: D501.1 (A), D502.1 (A), D503.1 (A), D504.1 (A), D505.1 (A), D506.1 (A), D507.1 (A), D508.1 (A), R501.2, R505.1, R507.1, R509.2, R515.2, U501.1 (ADDR0), U501.4 (VCC), U501.8 (EN), U502.4 (VCC), U502.8 (EN); also elsewhere on the board
/Interface/2AX_H: RV503.2b; also elsewhere on the board
/Interface/2AX_V: RV503.2a; also elsewhere on the board
/Interface/ENC_A: C501.1, R502.2; also elsewhere on the board
/Interface/ENC_B: C502.1, R508.1; also elsewhere on the board
/Interface/ENC_SW: SW501.S2; also elsewhere on the board
/Interface/POT_A: RV501.2; also elsewhere on the board
/Interface/POT_B: RV502.2; also elsewhere on the board
/Interface/RGB_SCL: U501.7 (SCL), U502.7 (SCL); also elsewhere on the board
/Interface/RGB_SDA: U501.5 (SDA), U502.5 (SDA); also elsewhere on the board
/Interface/SW_Center: SW502.2; also elsewhere on the board
/Interface/SW_Down: SW502.6; also elsewhere on the board
/Interface/SW_Left: SW502.3; also elsewhere on the board
/Interface/SW_Right: SW502.4; also elsewhere on the board
/Interface/SW_Up: SW502.1; also elsewhere on the board
/Interface/T_BUTTON1: R503.2, R504.1; also elsewhere on the board
/Interface/T_BUTTON2: R510.2, R511.1; also elsewhere on the board
/Interface/T_LOAD: R503.1, R510.1, R513.1, R517.1; also elsewhere on the board
/Interface/T_SLIDER1: R513.2, R514.1; also elsewhere on the board
/Interface/T_SLIDER2: R517.2, R518.1; also elsewhere on the board
GND: C501.2, C502.2, C503.2, C504.2, R506.1, R512.1, R516.1, R519.2, R520.2, RV501.3, RV502.3, RV503.1a, RV503.3b, SW501.C, SW501.S1, SW502.5, U501.2 (AGND), U501.3 (ADDR1), U501.6 (PGND), U501.18 (DGND), U502.1 (ADDR0), U502.2 (AGND), U502.3 (ADDR1), U502.6 (PGND), U502.18 (DGND); also elsewhere on the board
unnamed: C503.1, U501.10 (VCAP)
unnamed: C504.1, U502.10 (VCAP)
unnamed: D501.2 (RK), U501.12 (OUT0)
unnamed: D501.3 (GK), U501.13 (OUT1)
unnamed: D501.4 (BK), U501.14 (OUT2)
unnamed: D502.2 (RK), U501.15 (OUT3)
unnamed: D502.3 (GK), U501.16 (OUT4)
unnamed: D502.4 (BK), U501.17 (OUT5)
unnamed: D503.2 (RK), U501.19 (OUT6)
unnamed: D503.3 (GK), U501.20 (OUT7)
unnamed: D503.4 (BK), U501.21 (OUT8)
unnamed: D504.2 (RK), U501.22 (OUT9)
unnamed: D504.3 (GK), U501.23 (OUT10)
unnamed: D504.4 (BK), U501.24 (OUT11)
unnamed: D505.2 (RK), U502.12 (OUT0)
unnamed: D505.3 (GK), U502.13 (OUT1)
unnamed: D505.4 (BK), U502.14 (OUT2)
unnamed: D506.2 (RK), U502.15 (OUT3)
unnamed: D506.3 (GK), U502.16 (OUT4)
unnamed: D506.4 (BK), U502.17 (OUT5)
unnamed: D507.2 (RK), U502.19 (OUT6)
unnamed: D507.3 (GK), U502.20 (OUT7)
unnamed: D507.4 (BK), U502.21 (OUT8)
unnamed: D508.2 (RK), U502.22 (OUT9)
unnamed: D508.3 (GK), U502.23 (OUT10)
unnamed: D508.4 (BK), U502.24 (OUT11)
unnamed: R501.1, R506.2, VC501.2
unnamed: R502.1, R505.2, SW501.A
unnamed: R504.2, VC501.1
unnamed: R507.2, R508.2, SW501.B
unnamed: R509.1, R512.2, VC502.2
unnamed: R511.2, VC502.1
unnamed: R514.2, VC503.1
unnamed: R515.1, R516.2, VC503.3
unnamed: R518.2, VC503.2
unnamed: R519.1, U501.9 (IREF)
unnamed: R520.1, U502.9 (IREF)

Notes on the sheet:
8x RGB LEDs with I2C constant current sink driver
Rotational Inputs
Directional Inputs
IREF Resistor: 4k7 = 15.6 mA
Capacitive Touch Pads
I2C adresses: LED 1-4: 0b0010100 LED 2-8: 0b0010101 Broadcast: 0b0001100

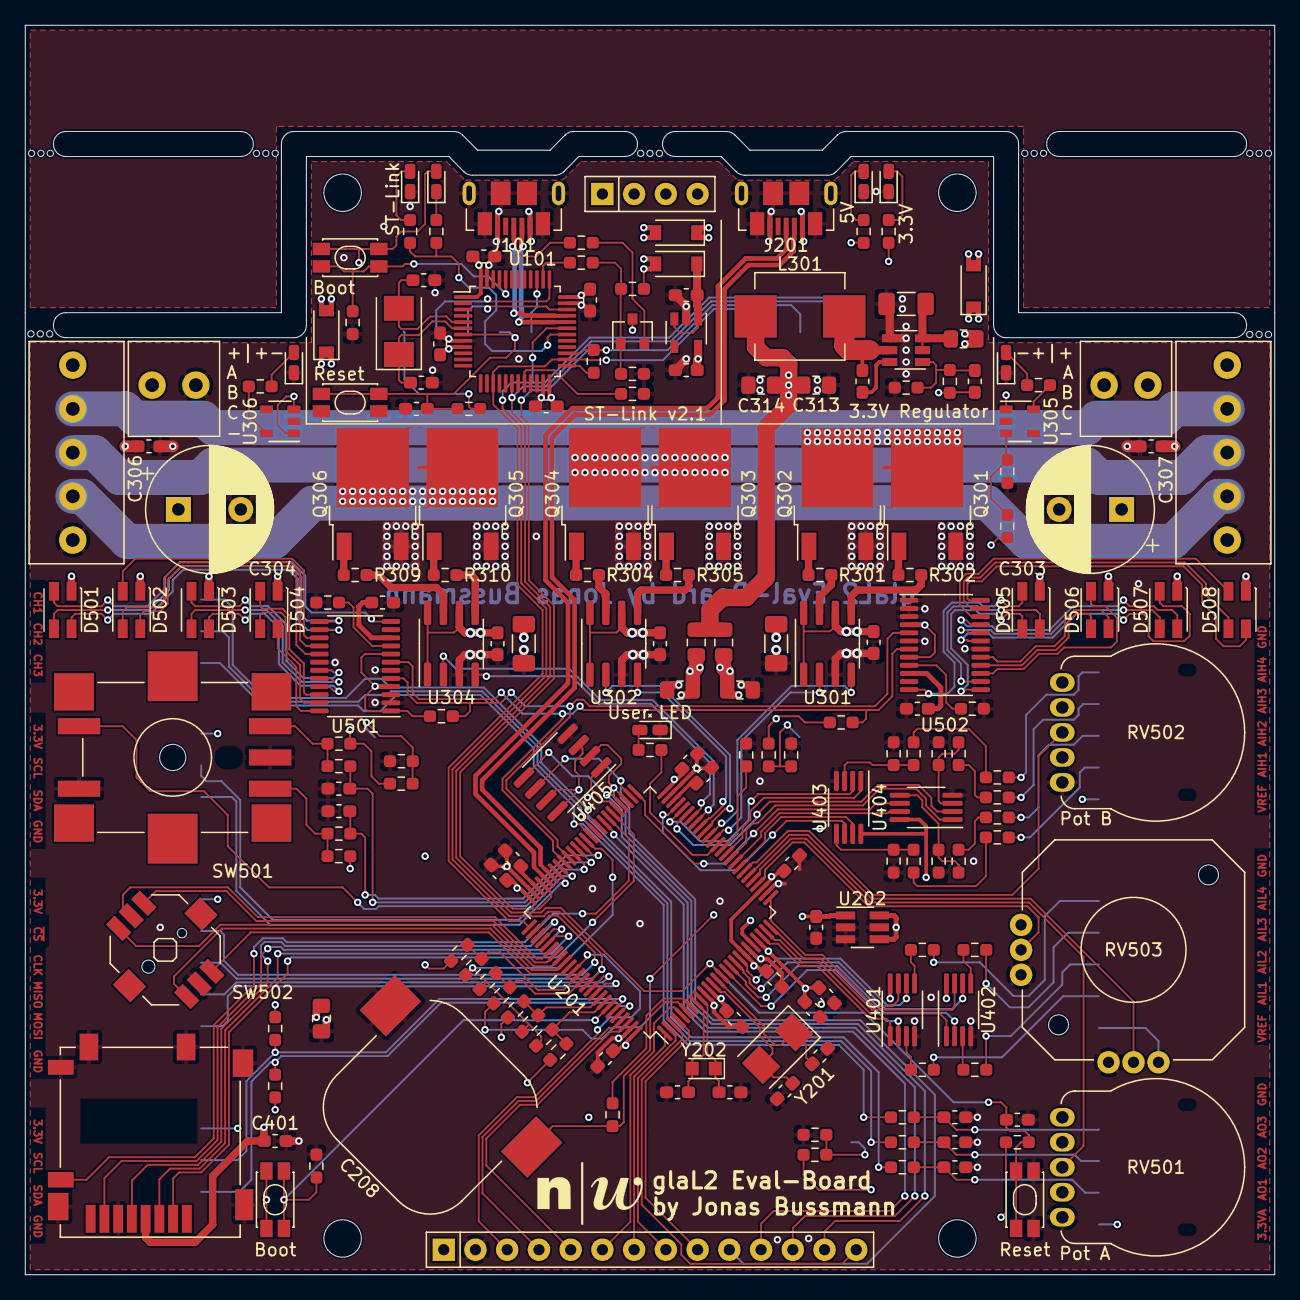
[picture p26: board STM32-Evalboard.kicad_pcb from above]

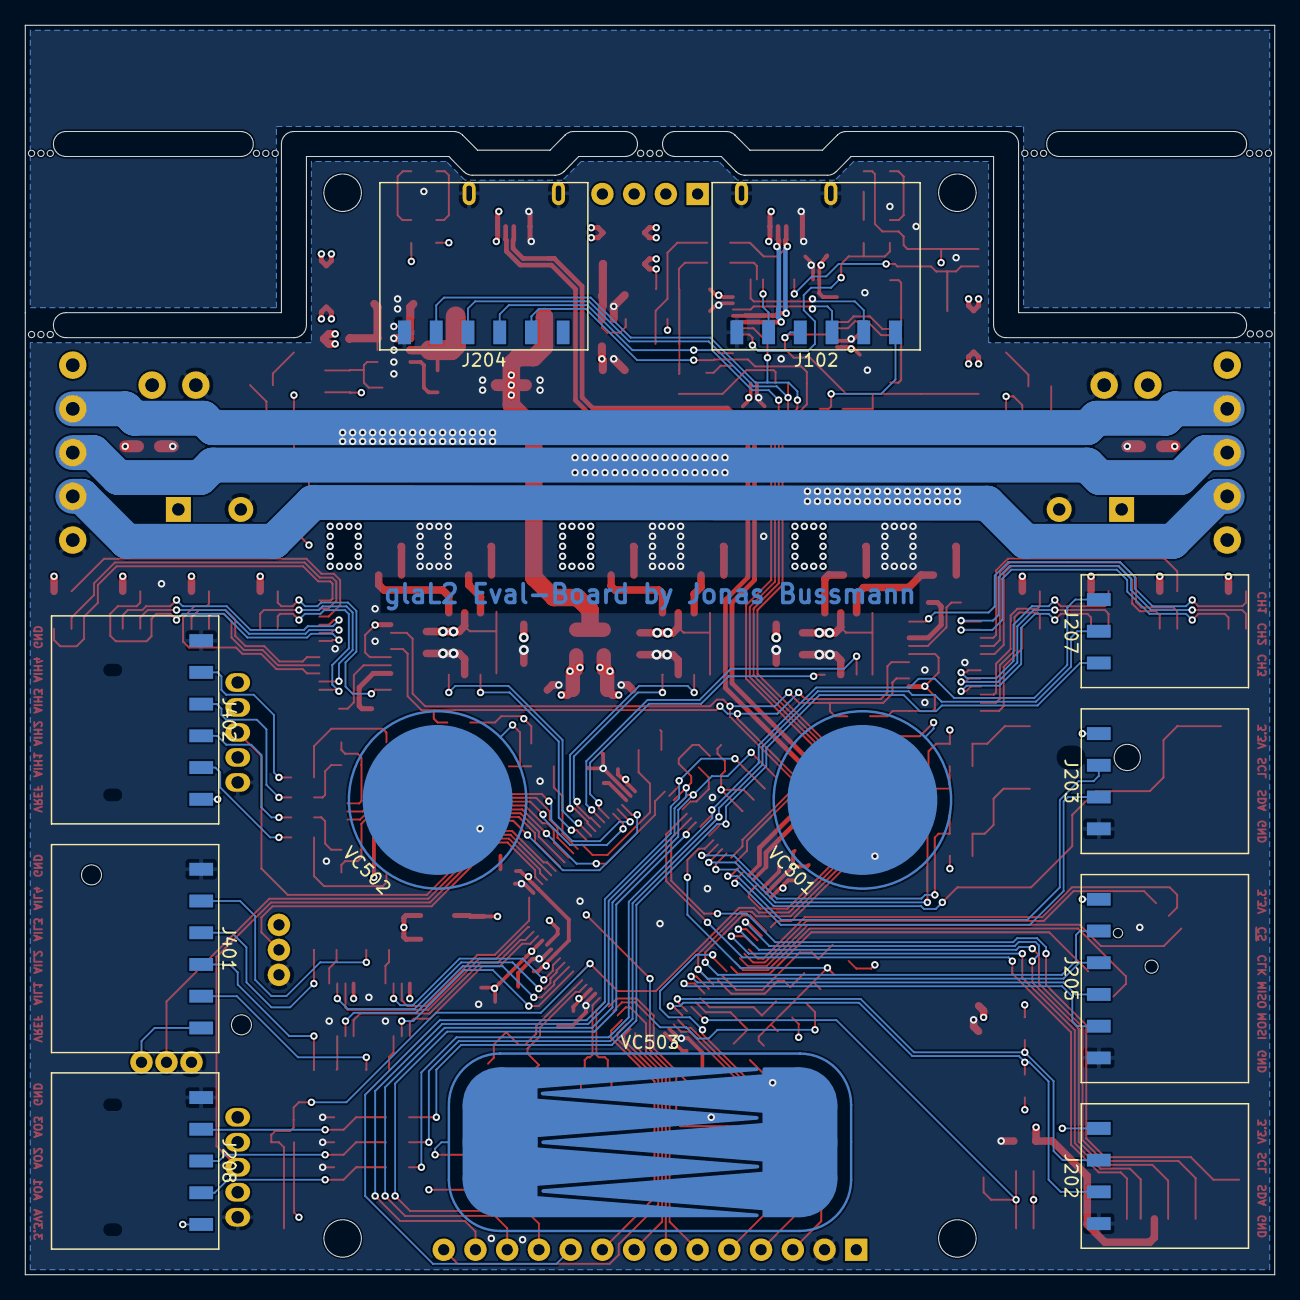
[picture p27: board STM32-Evalboard.kicad_pcb from below]

Board: 4 copper layers, 100.0 x 100.0 mm, 207 parts (12 on the bottom side), 200 nets.
