jbussmann/glaL2-Leiterplatte/Datasheets_MCU/CubeMX/CubeMX.ioc

Mcu.UserName=STM32F411VCTx
PA0-WKUP.Signal=ADCx_IN0
PA1.Signal=ADCx_IN1
PA10.Signal=USART1_RX
PA11.Signal=USB_OTG_FS_DM
PA12.Signal=USB_OTG_FS_DP
PA13.Signal=SYS_JTMS-SWDIO
PA14.Signal=SYS_JTCK-SWCLK
PA15.Signal=SPI1_NSS
PA2.Signal=ADCx_IN2
PA3.Signal=ADCx_IN3
PA4.Signal=ADCx_IN4
PA5.Signal=ADCx_IN5
PA6.Signal=ADCx_IN6
PA7.Signal=ADCx_IN7
PA8.GPIO_Label=LED_SCL
PA8.Signal=I2C3_SCL
PA9.Signal=USART1_TX
PB0.Signal=ADCx_IN8
PB1.Signal=ADCx_IN9
PB10.GPIO_Label=GSEL_H1
PB10.Signal=GPIO_Output
PB12.GPIO_Label=GSEL_H2
PB12.Signal=GPIO_Output
PB13.GPIO_Label=TOUCH/FLASH_SCK
PB13.Signal=SPI2_SCK
PB14.GPIO_Label=TOUCH/FLASH_MISO
PB14.Signal=SPI2_MISO
PB15.GPIO_Label=TOUCH/FLASH_MOSI
PB15.Signal=SPI2_MOSI
PB2.GPIO_Label=BOOT1
PB2.Signal=GPIO_Input
PB3.Signal=SPI1_SCK
PB4.Signal=SPI1_MISO
PB5.Signal=SPI1_MOSI
PB6.GPIO_Label=T_SLIDER1
PB6.Signal=GPIO_Output
PB7.GPIO_Label=T_SLIDER2
PB7.Signal=GPIO_Output
PB8.Signal=I2C1_SCL
PB9.Signal=I2C1_SDA
PC0.GPIO_Label=GSEL_L1
PC0.Signal=GPIO_Output
PC1.GPIO_Label=GSEL_L2
PC1.Signal=GPIO_Output
PC10.GPIO_Label=SD_SCK
PC10.Signal=SPI3_SCK
PC11.GPIO_Label=SD_MISO
PC11.Signal=SPI3_MISO
PC12.GPIO_Label=SD_MOSI
PC12.Signal=SPI3_MOSI
PC13-ANTI_TAMP.GPIO_Label=Vbat_Charge
PC13-ANTI_TAMP.Signal=GPIO_Output
PC14-OSC32_IN.Signal=RCC_OSC32_IN
PC15-OSC32_OUT.Signal=RCC_OSC32_OUT
PC2.GPIO_Label=GSEL_L3
PC2.Signal=GPIO_Output
PC3.GPIO_Label=GSEL_L4
PC3.Signal=GPIO_Output
PC4.Signal=ADCx_IN14
PC5.Signal=ADCx_IN15
PC6.GPIO_Label=ENC_A
PC6.Signal=S_TIM3_CH1
PC7.GPIO_Label=ENC_B
PC7.Signal=S_TIM3_CH2
PC8.GPIO_Label=ENC_SW
PC8.Signal=GPIO_Input
PC9.GPIO_Label=LED_SDA
PC9.Signal=I2C3_SDA
PD0.GPIO_Label=SW_L
PD0.Signal=GPIO_Input
PD1.GPIO_Label=SW_C
PD1.Signal=GPIO_Input
PD10.GPIO_Label=SD_DET
PD10.Signal=GPIO_Input
PD11.GPIO_Label=TOUCH_CS
PD11.Signal=GPIO_Output
PD12.Signal=S_TIM4_CH1
PD13.Signal=S_TIM4_CH2
PD14.Signal=S_TIM4_CH3
PD15.GPIO_Label=T_LOAD
PD15.Signal=GPIO_Output
PD2.GPIO_Label=SW_R
PD2.Signal=GPIO_Input
PD3.GPIO_Label=SW_D
PD3.Signal=GPIO_Input
PD4.GPIO_Label=SW_U
PD4.Signal=GPIO_Input
PD5.GPIO_Label=LCD_CS
PD5.Signal=GPIO_Output
PD6.GPIO_Label=T_BUTTON1
PD6.Signal=GPIO_Output
PD7.GPIO_Label=T_BUTTON2
PD7.Signal=GPIO_Output
PD8.GPIO_Label=FLASH_~CS
PD8.Signal=GPIO_Output
PD9.GPIO_Label=SD_~CS
PD9.Signal=GPIO_Output
PE0.GPIO_Label=LCD_RESET
PE0.Signal=GPIO_Output
PE1.GPIO_Label=LCD_DC
PE1.Signal=GPIO_Output
PE10.Signal=TIM1_CH2N
PE11.Signal=S_TIM1_CH2
PE12.Signal=TIM1_CH3N
PE13.Signal=S_TIM1_CH3
PE14.GPIO_Label=GSEL_H3
PE14.Signal=GPIO_Output
PE15.GPIO_Label=GSEL_H4
PE15.Signal=GPIO_Output
PE2.GPIO_Label=LCD_SCK
PE2.Signal=SPI5_SCK
PE3.GPIO_Label=LCD_LED
PE3.Signal=GPIO_Output
PE4.GPIO_Label=TOUCH_IRQ
PE4.Signal=GPIO_Output
PE5.GPIO_Label=LCD_MISO
PE5.Signal=SPI5_MISO
PE6.GPIO_Label=LCD_MOSI
PE6.Signal=SPI5_MOSI
PE7.GPIO_Label=LED
PE7.Signal=GPIO_Output
PE8.Signal=TIM1_CH1N
PE9.Signal=S_TIM1_CH1
