jbussmann/glaL2-Leiterplatte/(commit log)

2021-03-08 project init
    [Bauteilliste_Bosch_Bussmann_Ulmi.xlsx, Vorlage_Bestellliste.xlsx]
2021-08-02 project complete
    [Bauteilliste_Bosch_Bussmann_Ulmi.xlsx, Bauteilliste_Bussmann.xlsx, Bestellliste_glaL2_Bussmann.xlsx, Interface.sch, Microcontroller.sch, Periphery.sch, Power.sch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]
